turbana/cpu/doc/block_diagram.png

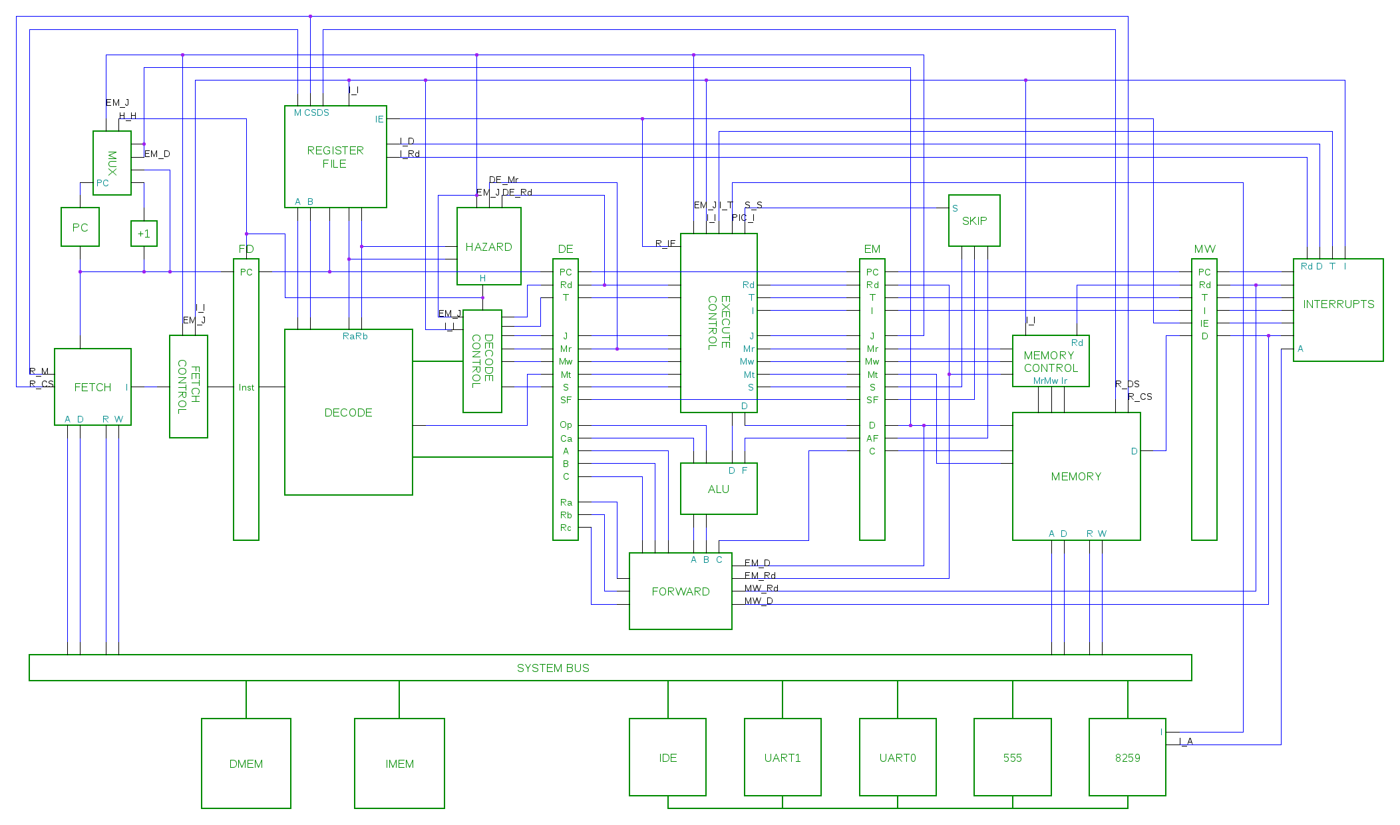
doc/block_diagram.png
