turbana/cpu/doc/schematics.pdf

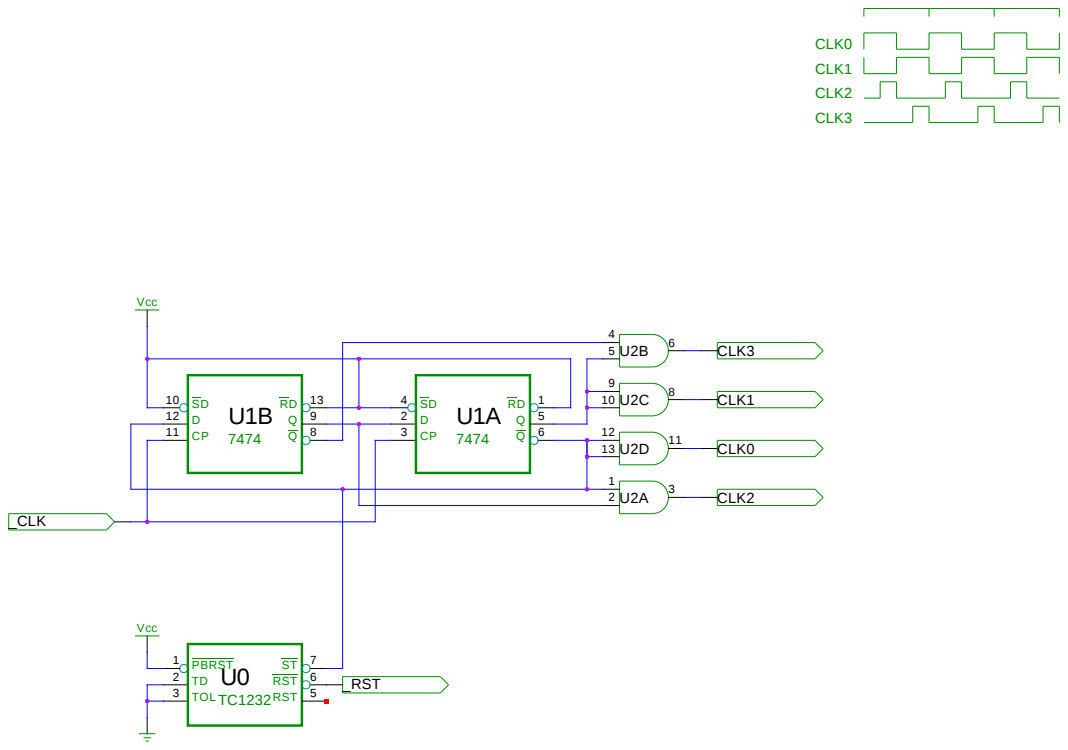
[picture p2: page 1]
FILE:; REVISION:; PAGE; DRAWN BY:; TITLE; Vcc; _CLK; CLK2; CLK0 CLK1 CLK2 CLK3; CLK3; CLK1; CLK0; _RST; 1 PBRST; 3 TOL; 7 ST RST 6 RST 5; CLOCK; 2016-08-04-103633 Ian Clark

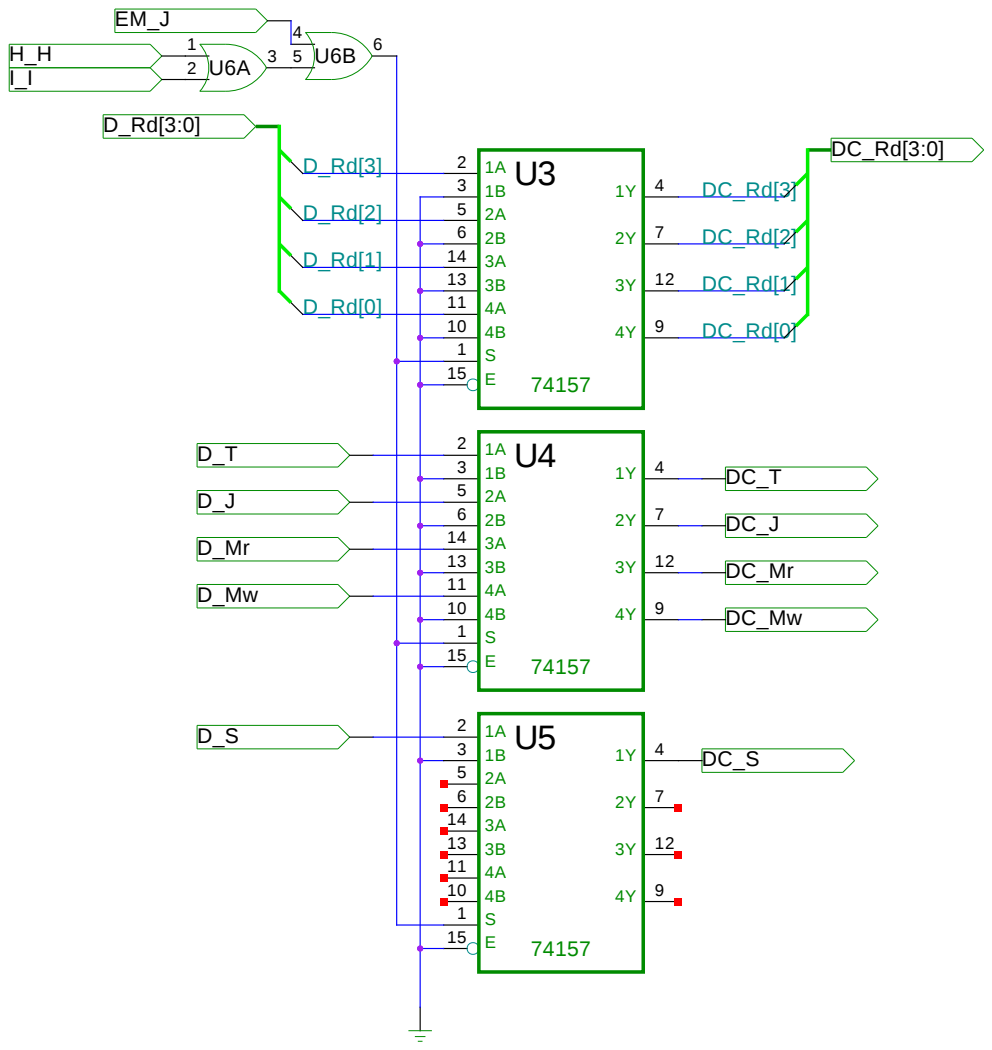
[picture p3: page 2]
FILE:; REVISION:; PAGE; DRAWN BY:; TITLE; DECODE CONTROL; 2016-07-01-140532 Ian Clark

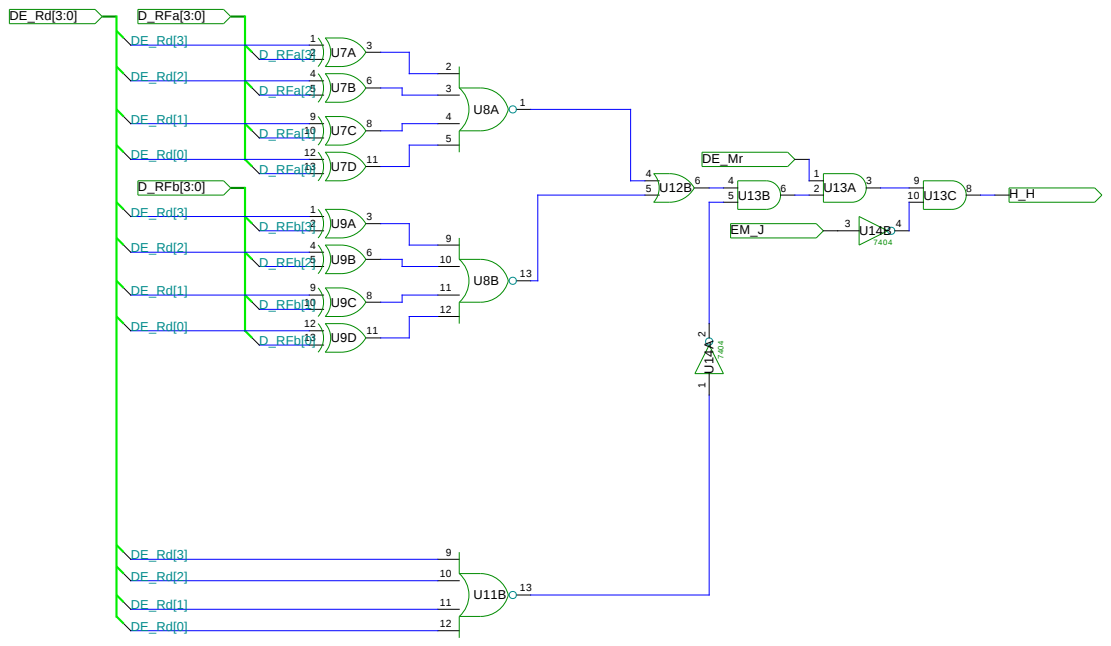
[picture p4: page 3]

# 7 EN 4 I0

# 10 S1 9 S2 3 I1 2 I2 1 I3

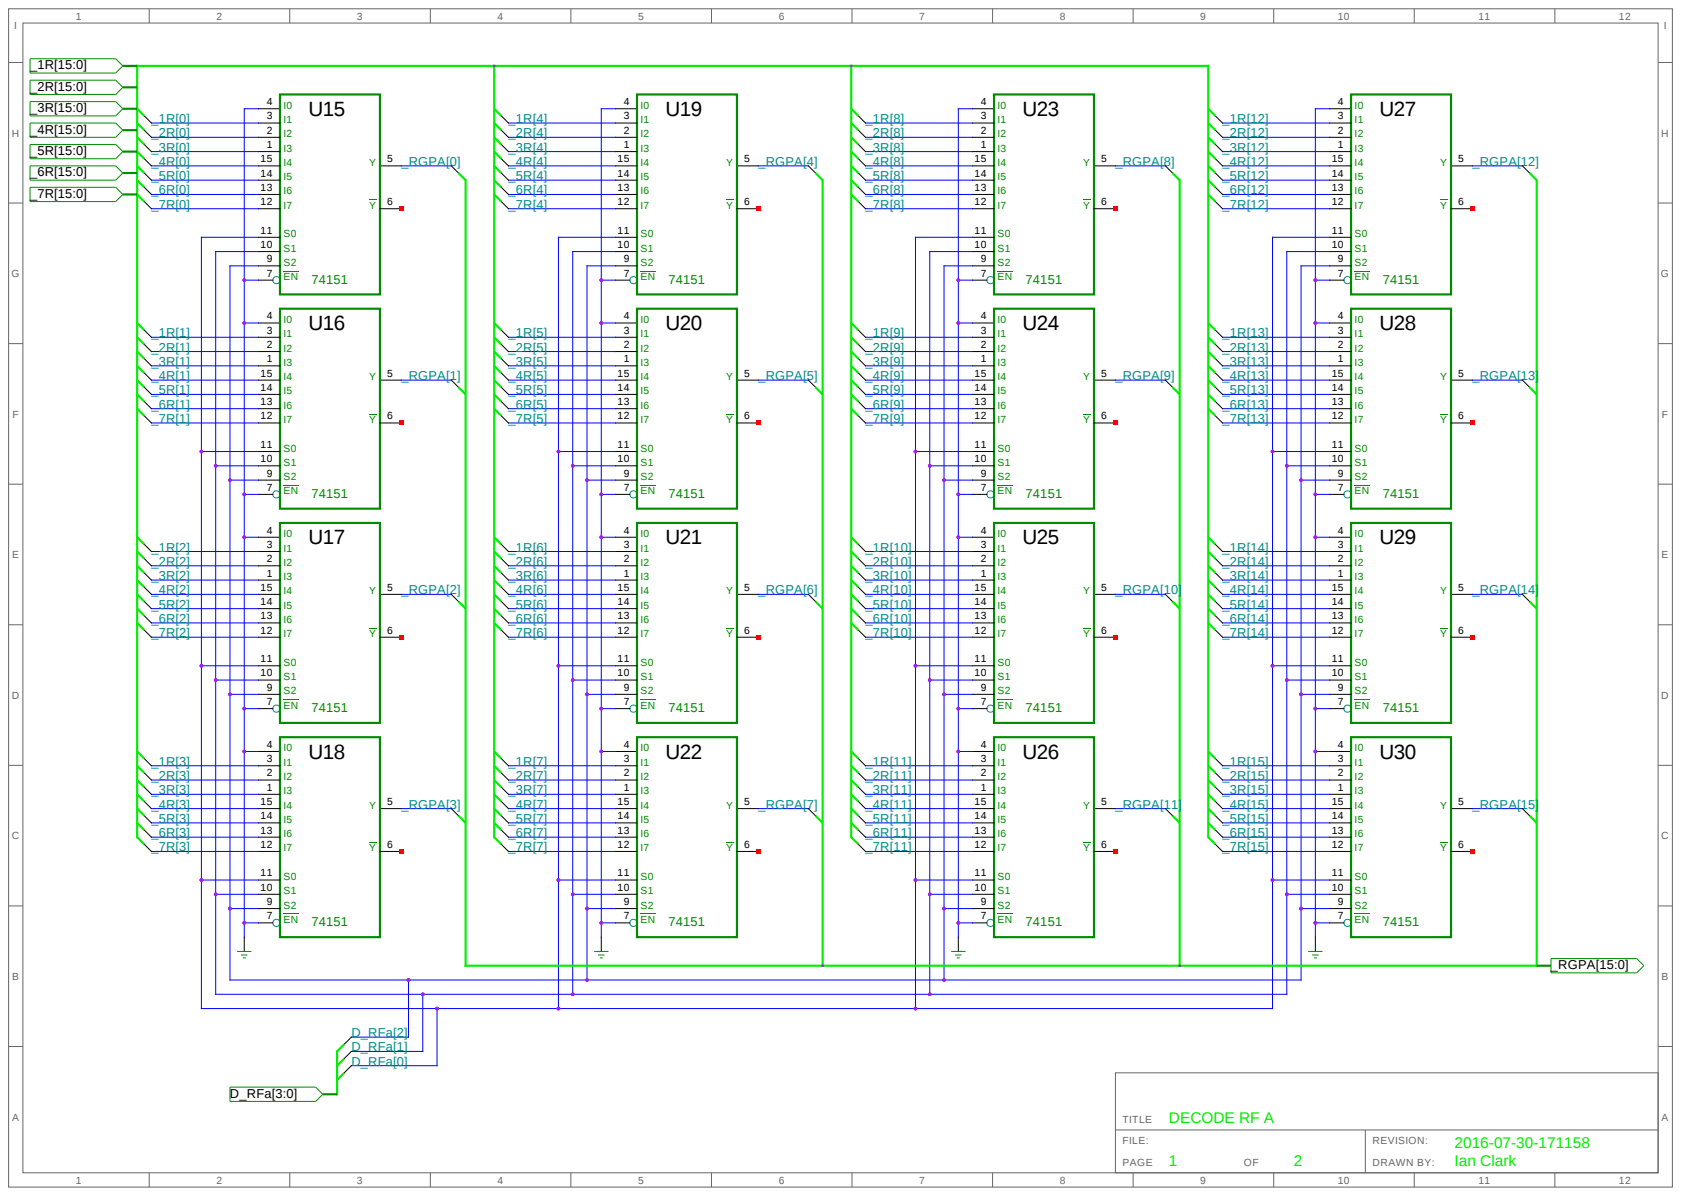
[picture p5: page 4]

# 1 EN1 2 B 3 1C3 4 1C2 5 1C1 6 1C0

U31

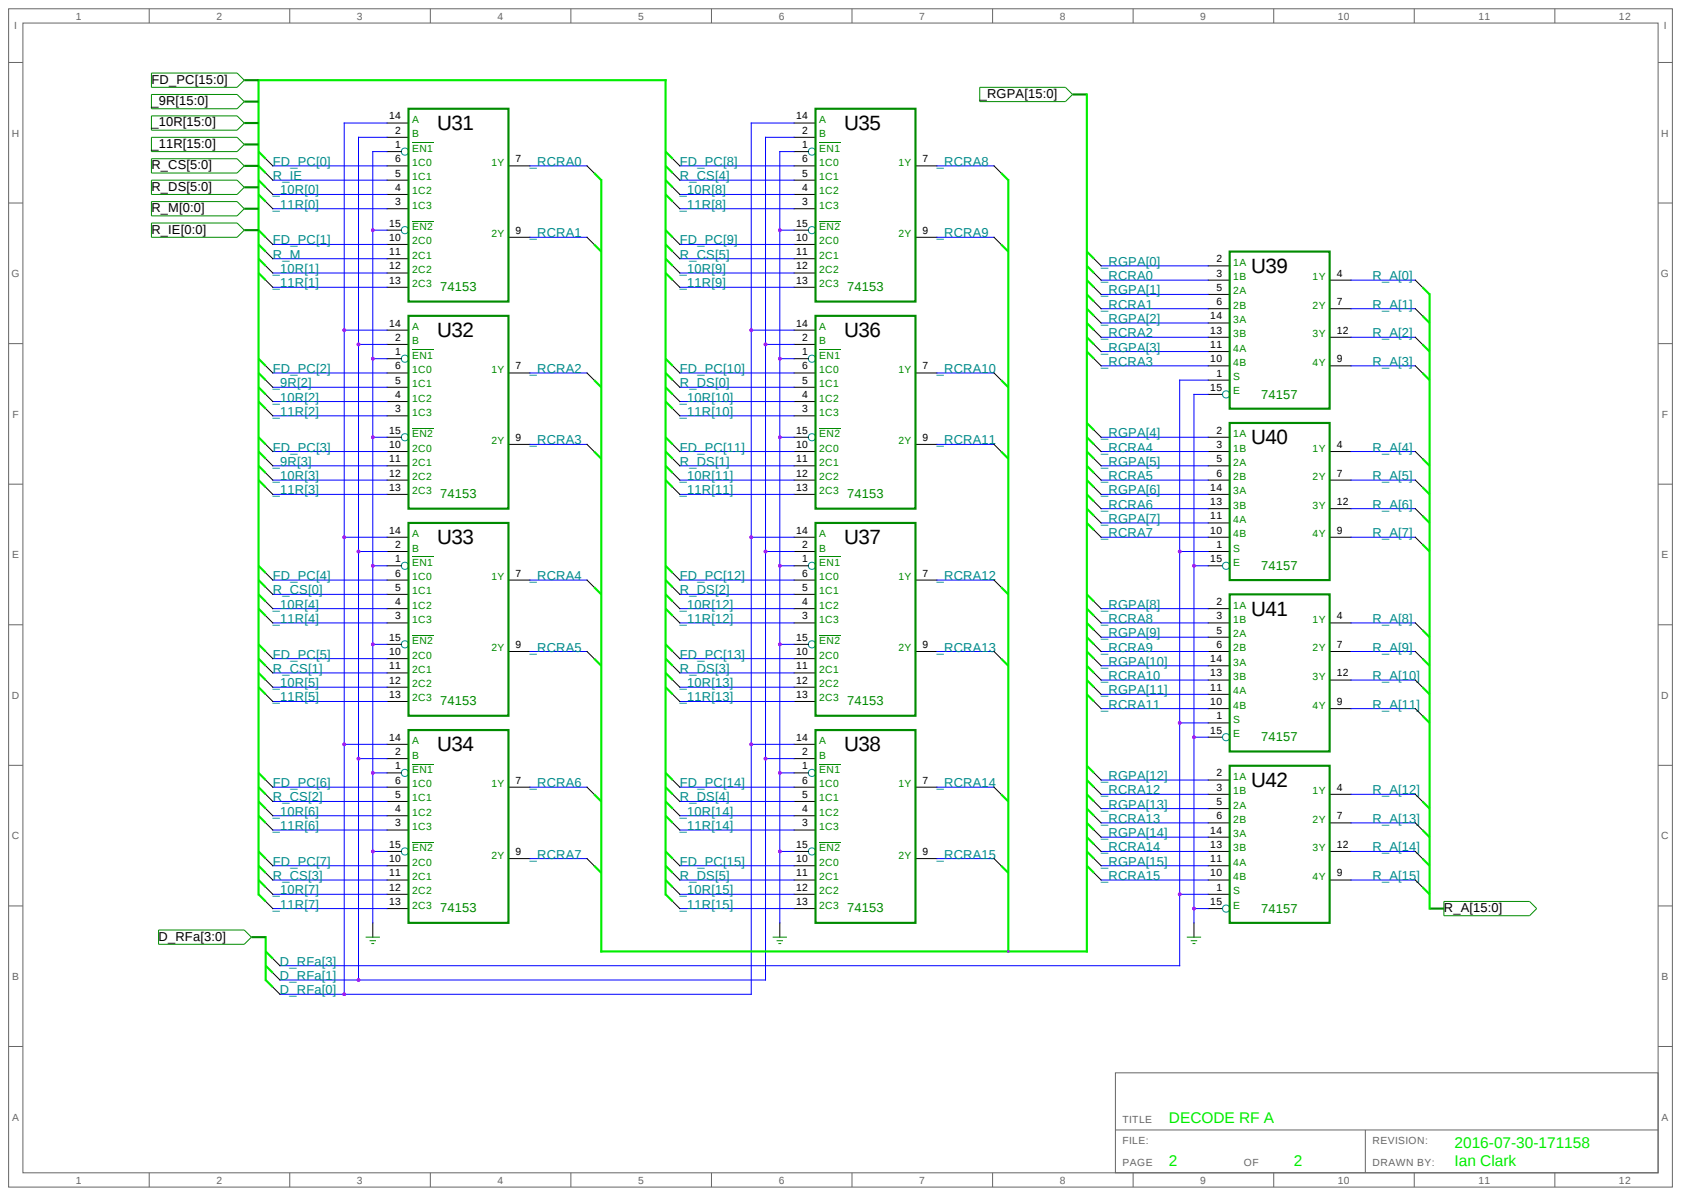
[picture p6: page 5]

# 7 EN 4 I0

# 10 S1 9 S2 3 I1 2 I2 1 I3

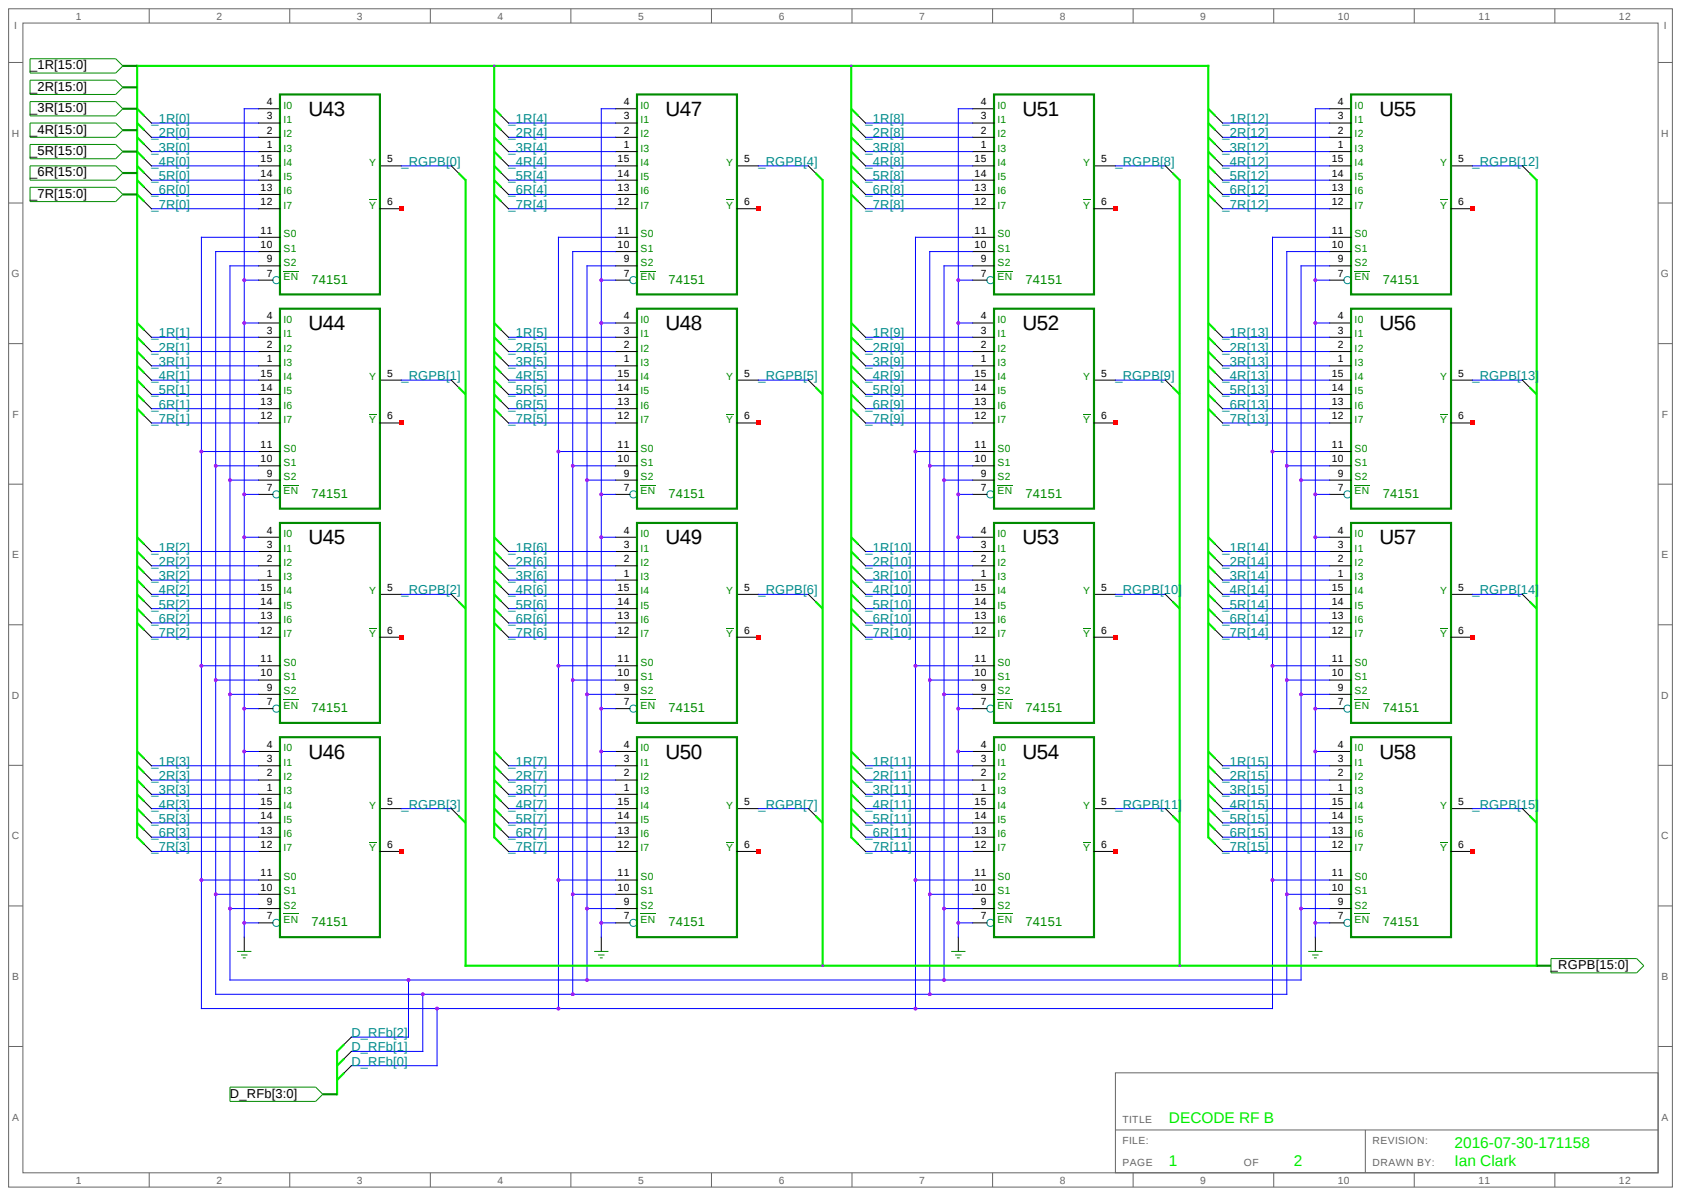
[picture p7: page 6]

# 1 EN1 2 B 3 1C3 4 1C2 5 1C1 6 1C0

U59

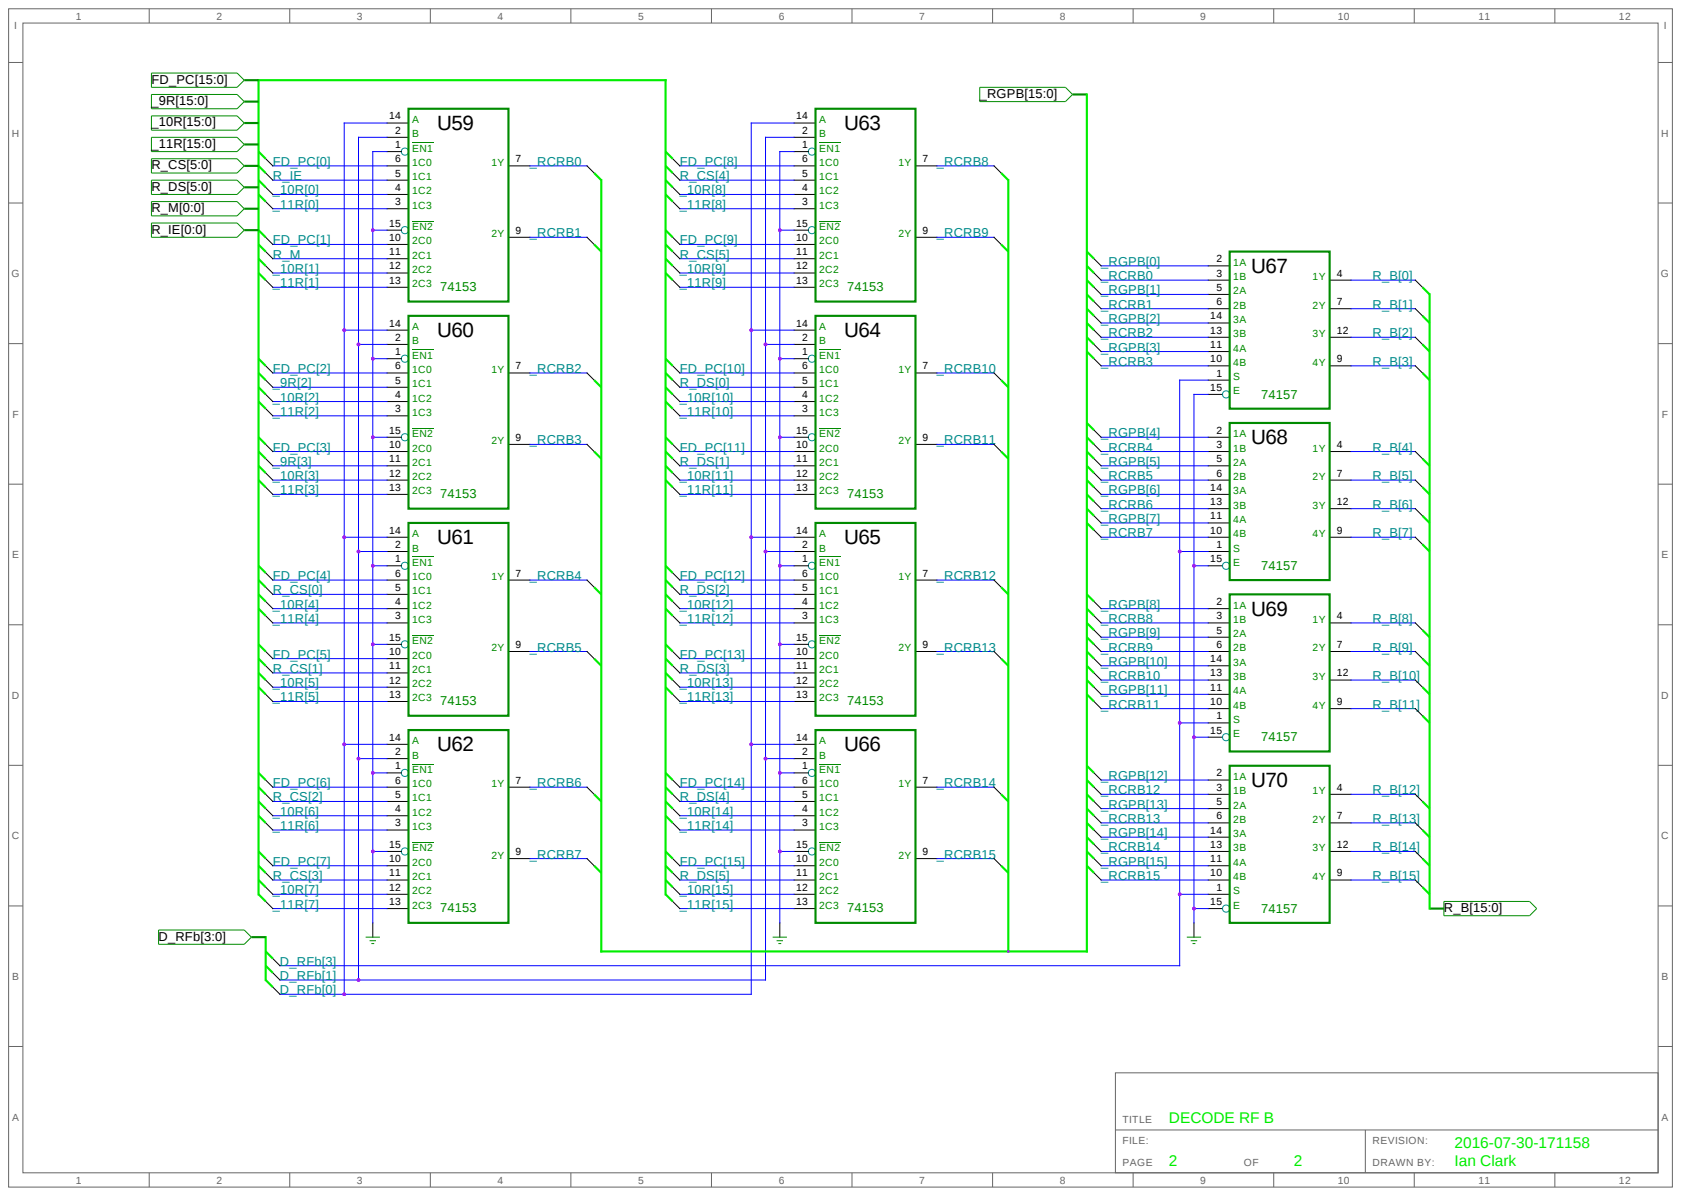
[picture p8: page 7]

U99

U367

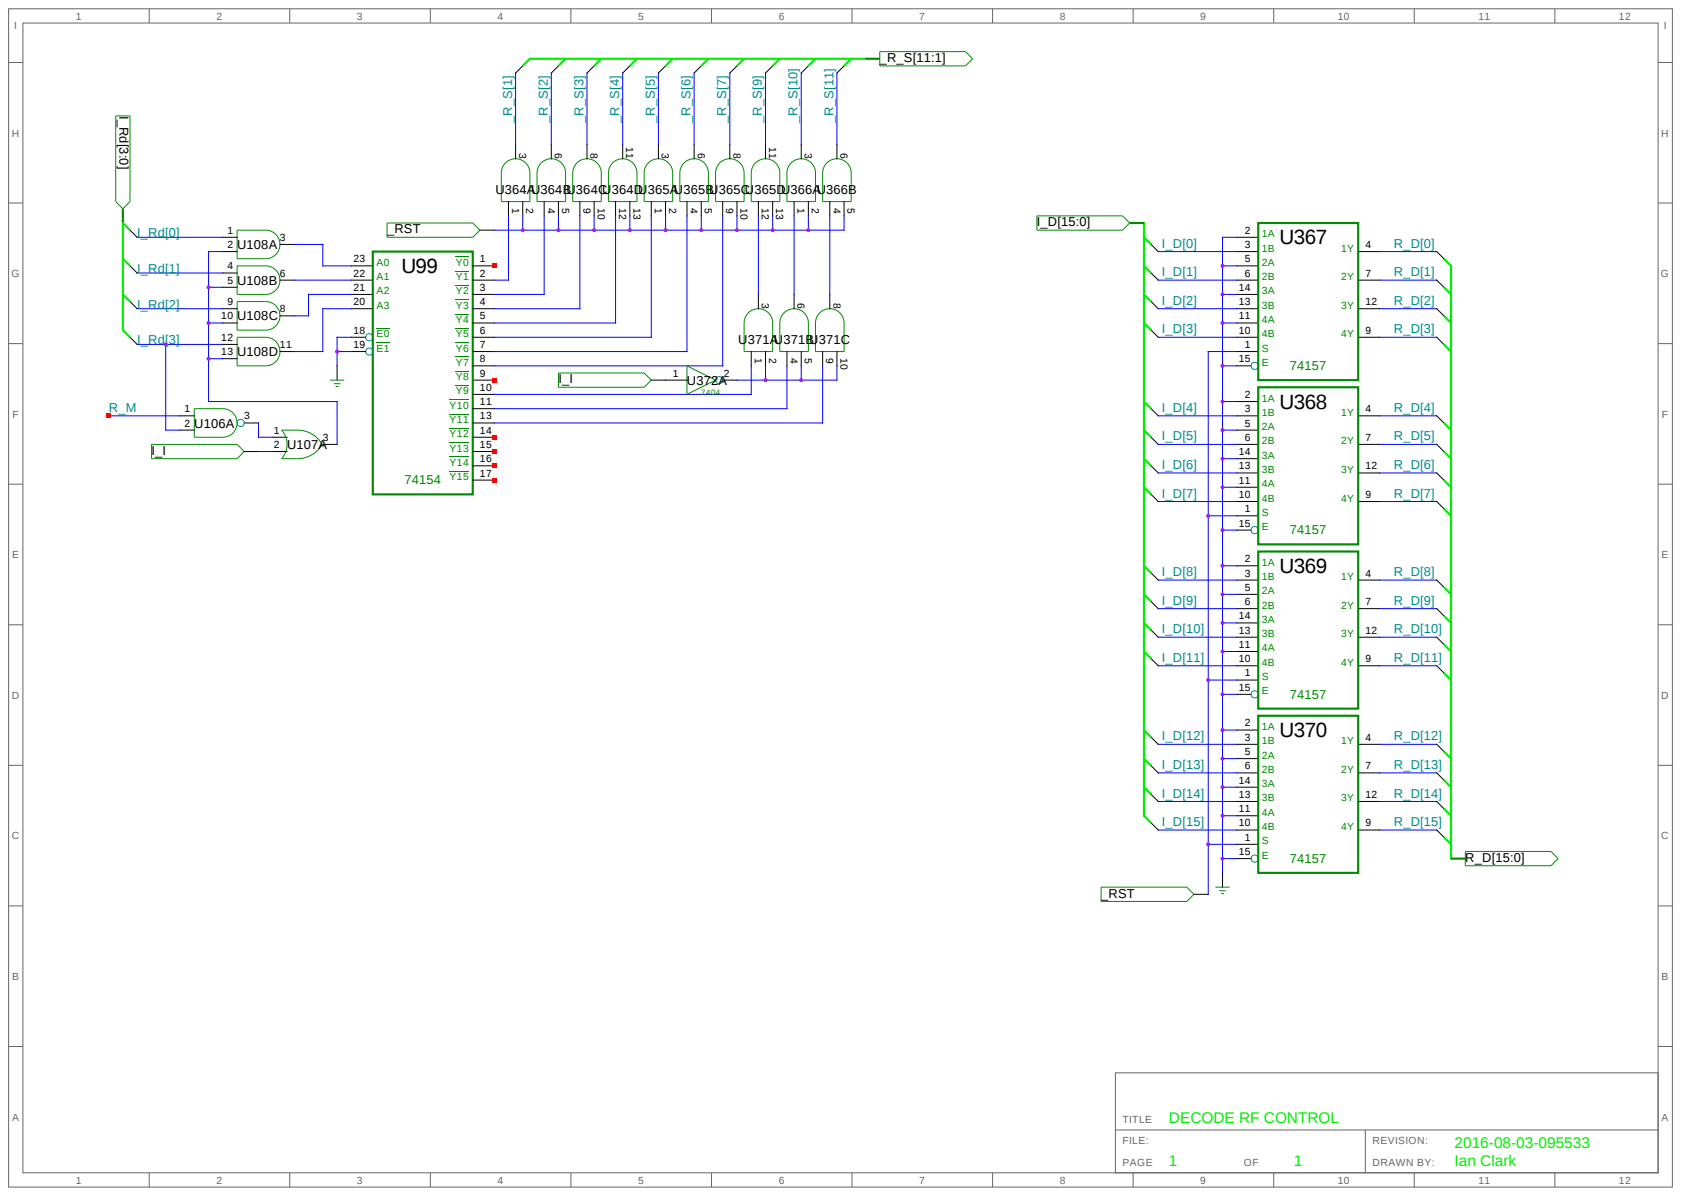
[picture p9: page 8]

U101

U105

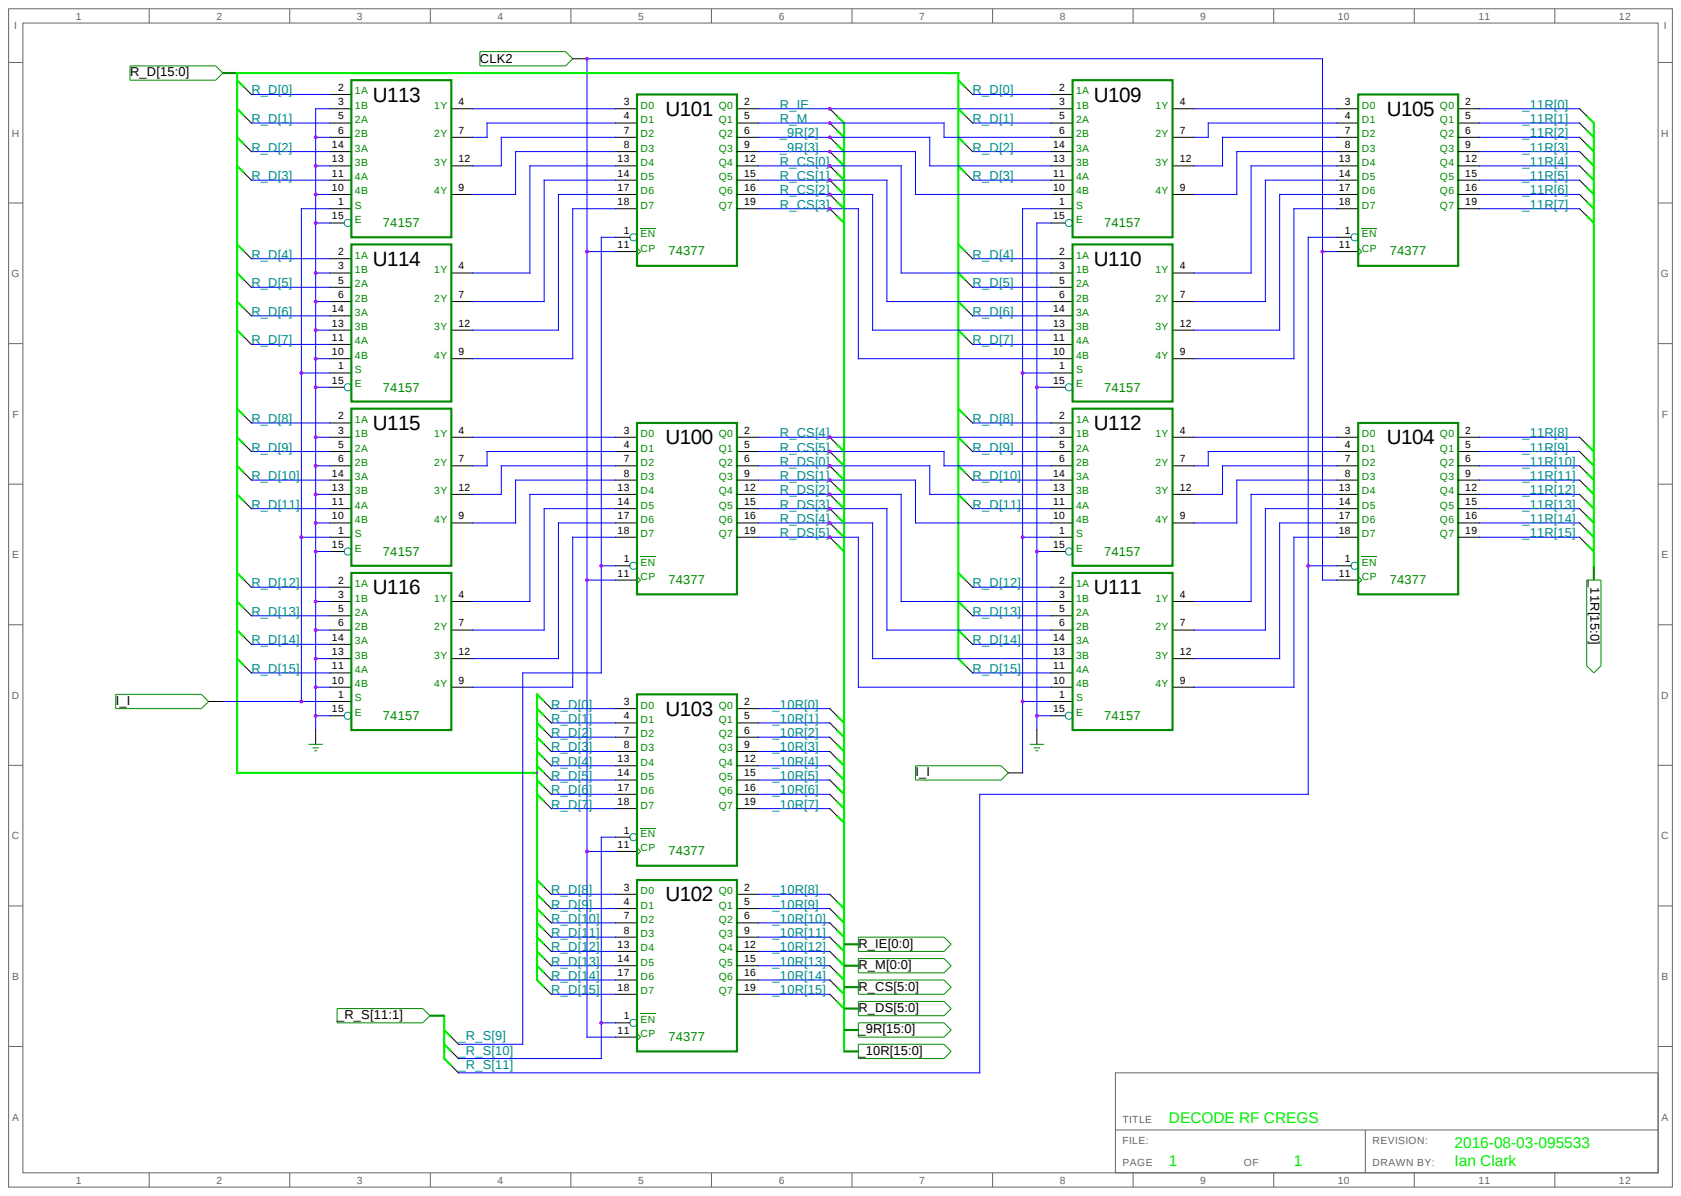
[picture p10: page 9]

14 D5
17 D6
18 D7

U118

U122

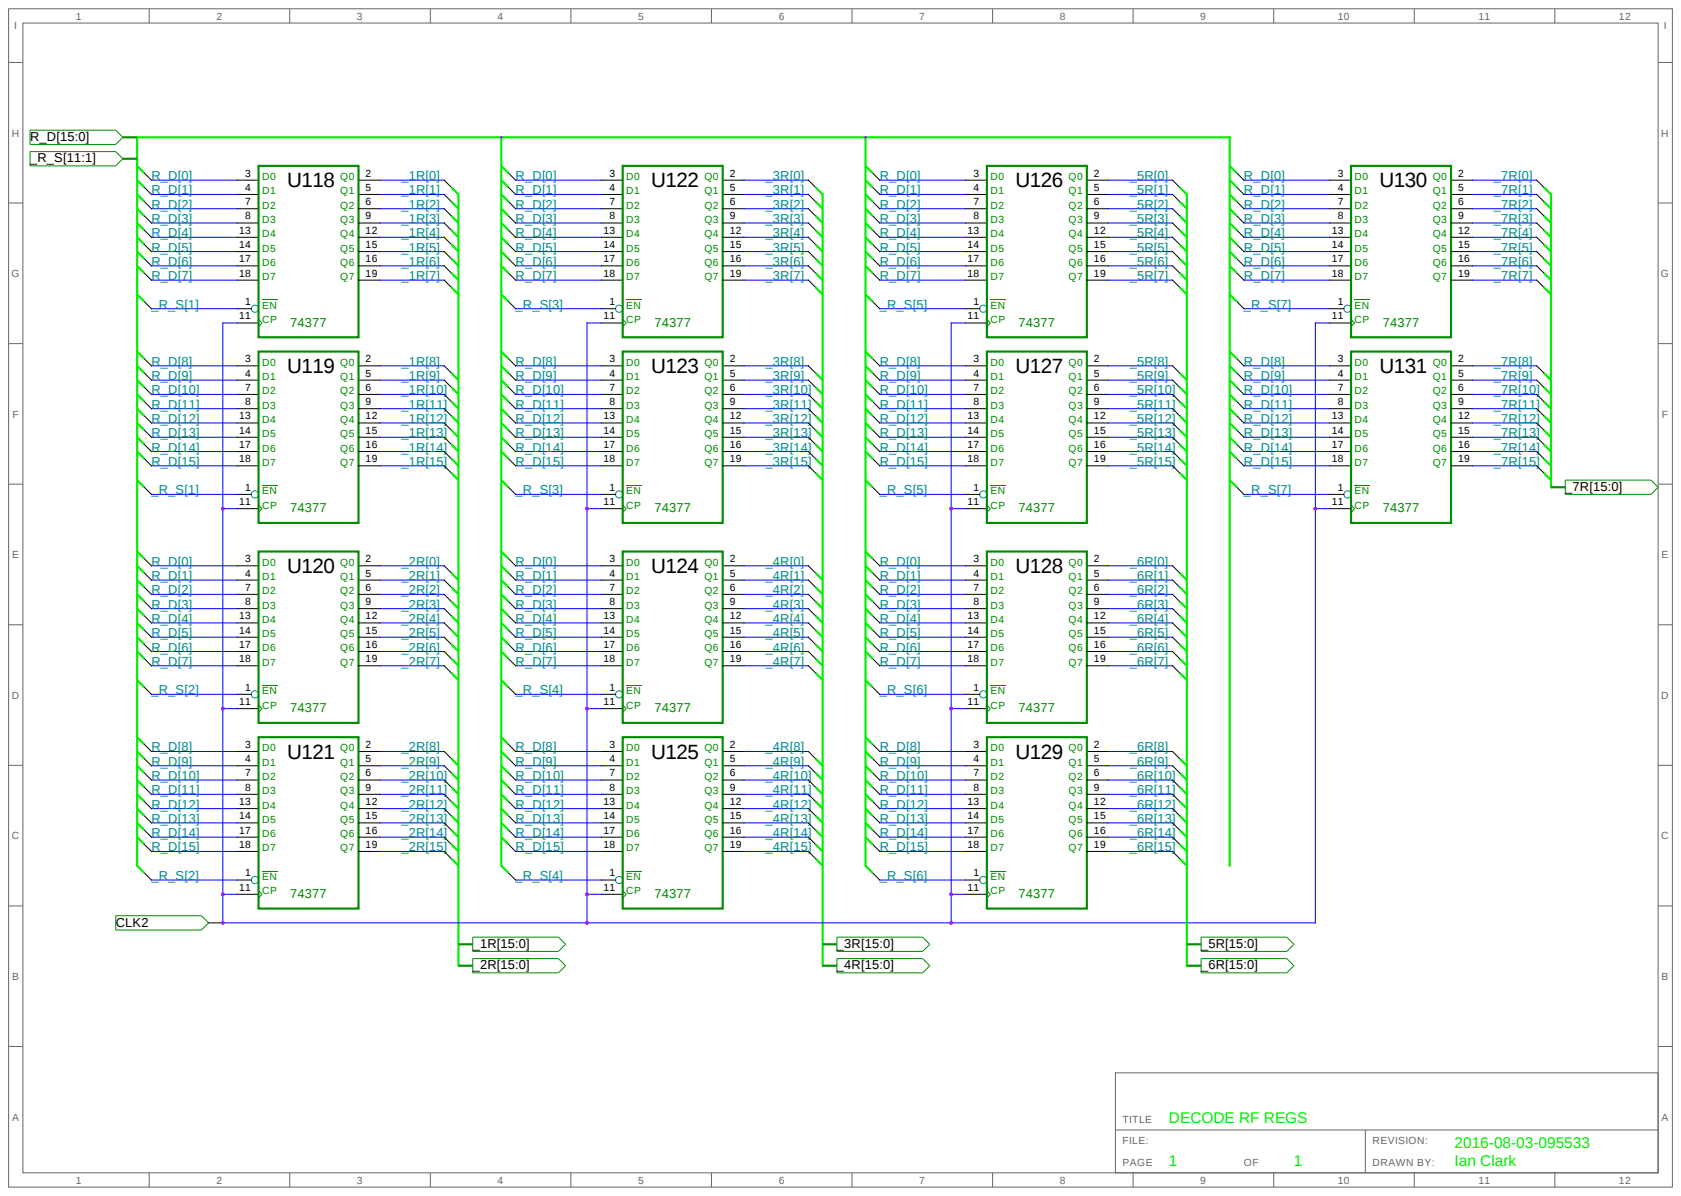
[picture p11: page 10]

U132
U136

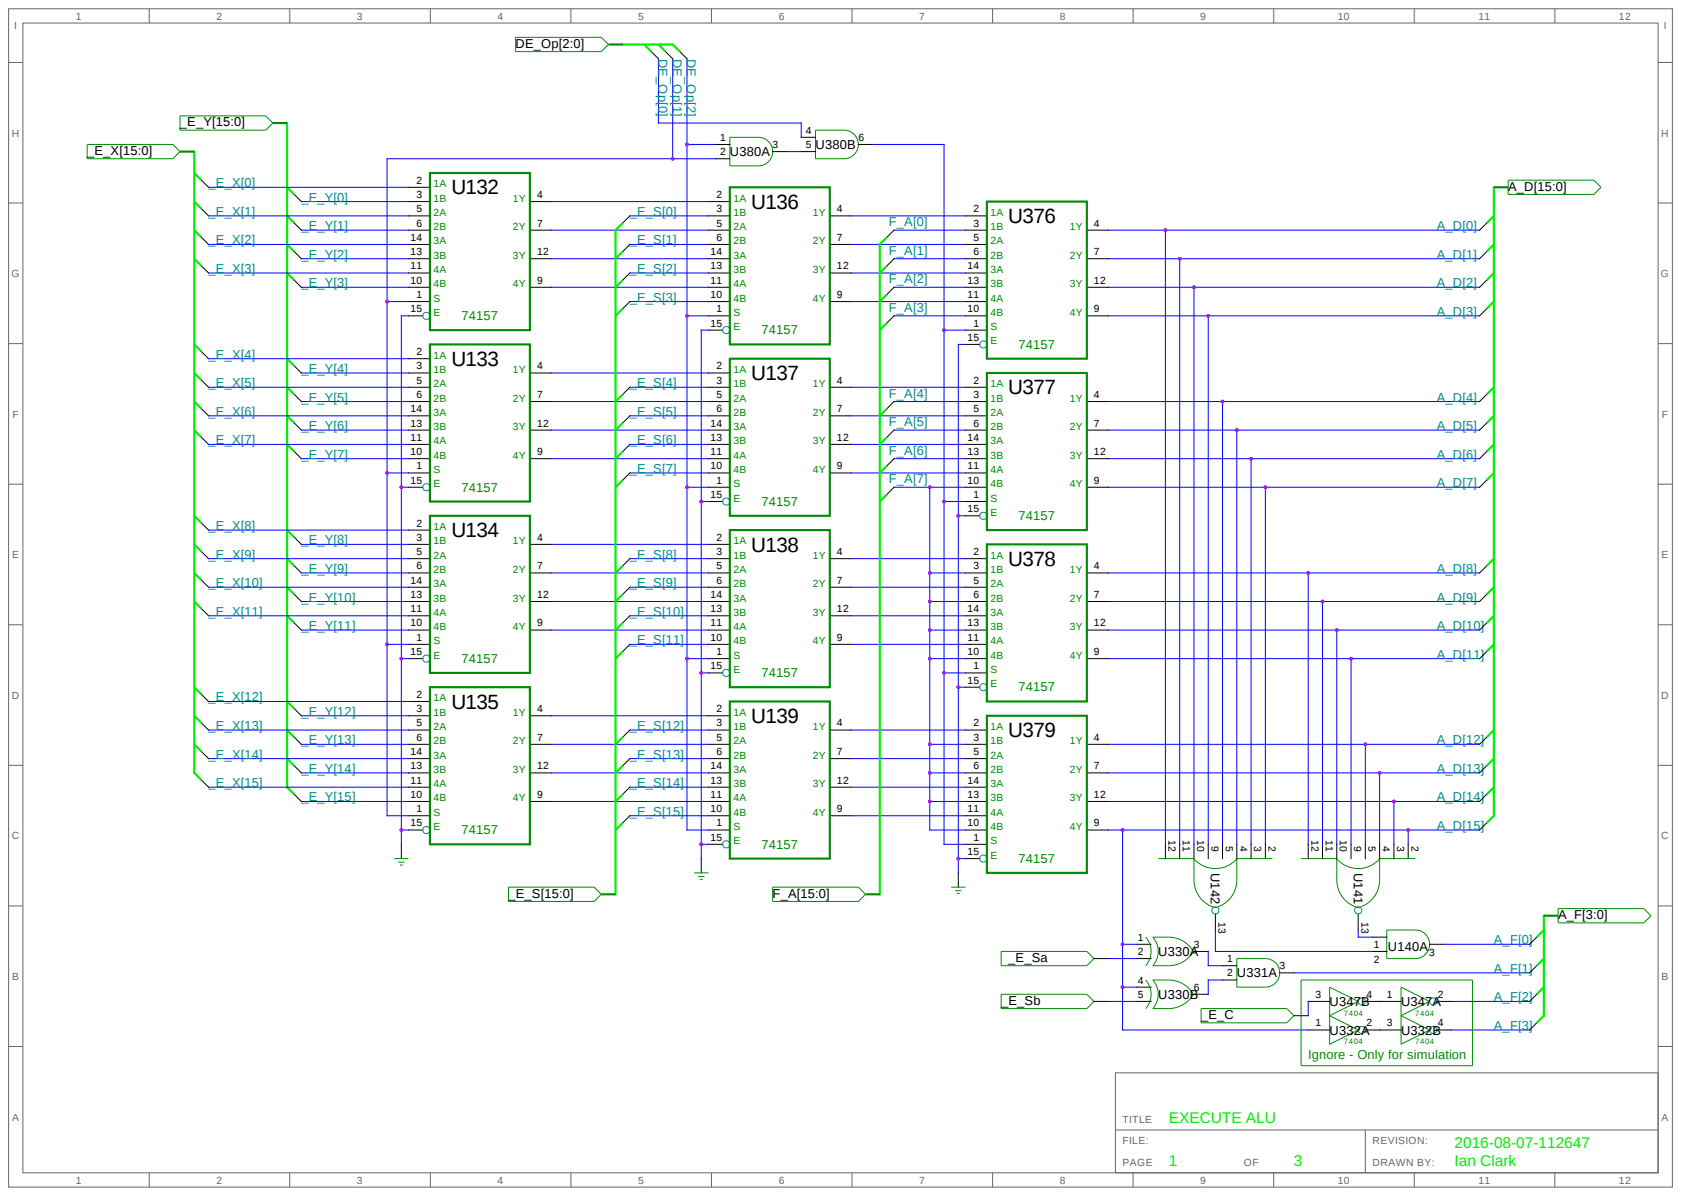
[picture p12: page 11]

6 2B
14 3A

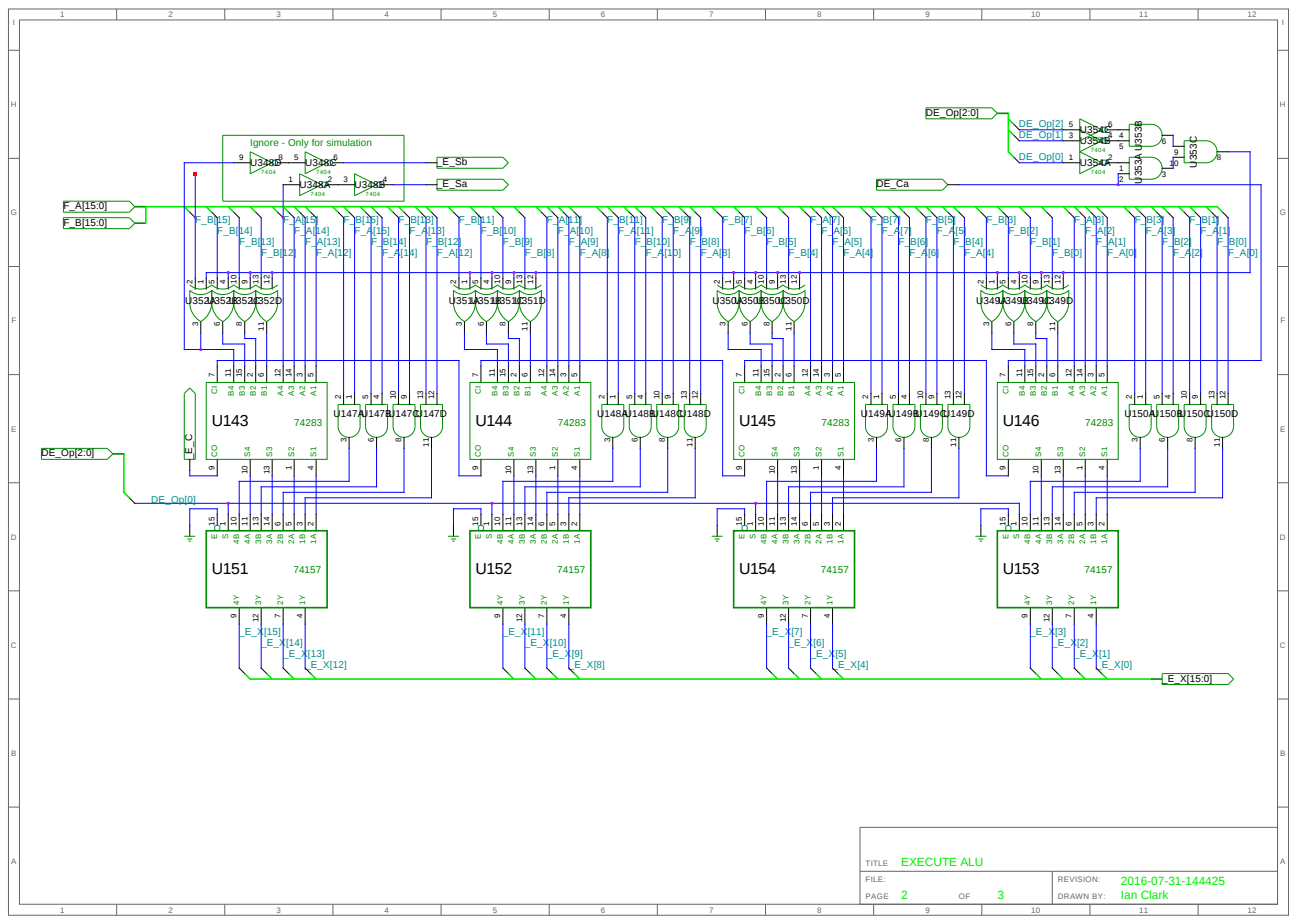
[picture p13: page 12]

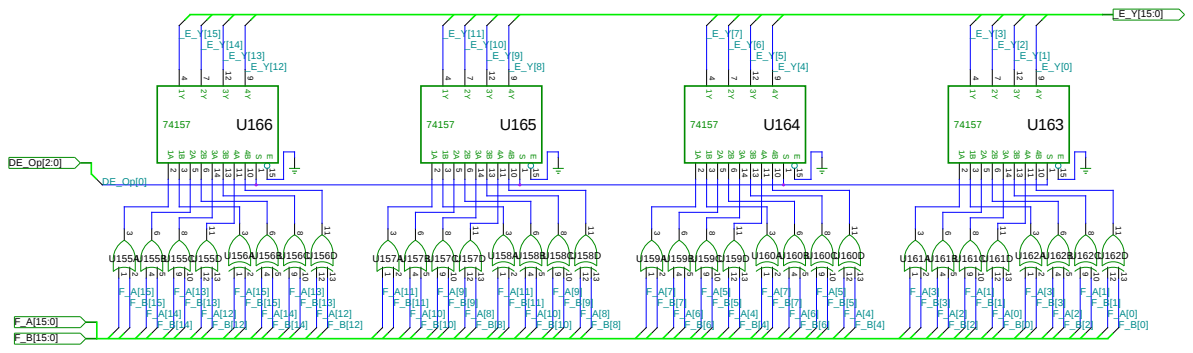
[picture p14: page 13]

U167
U171

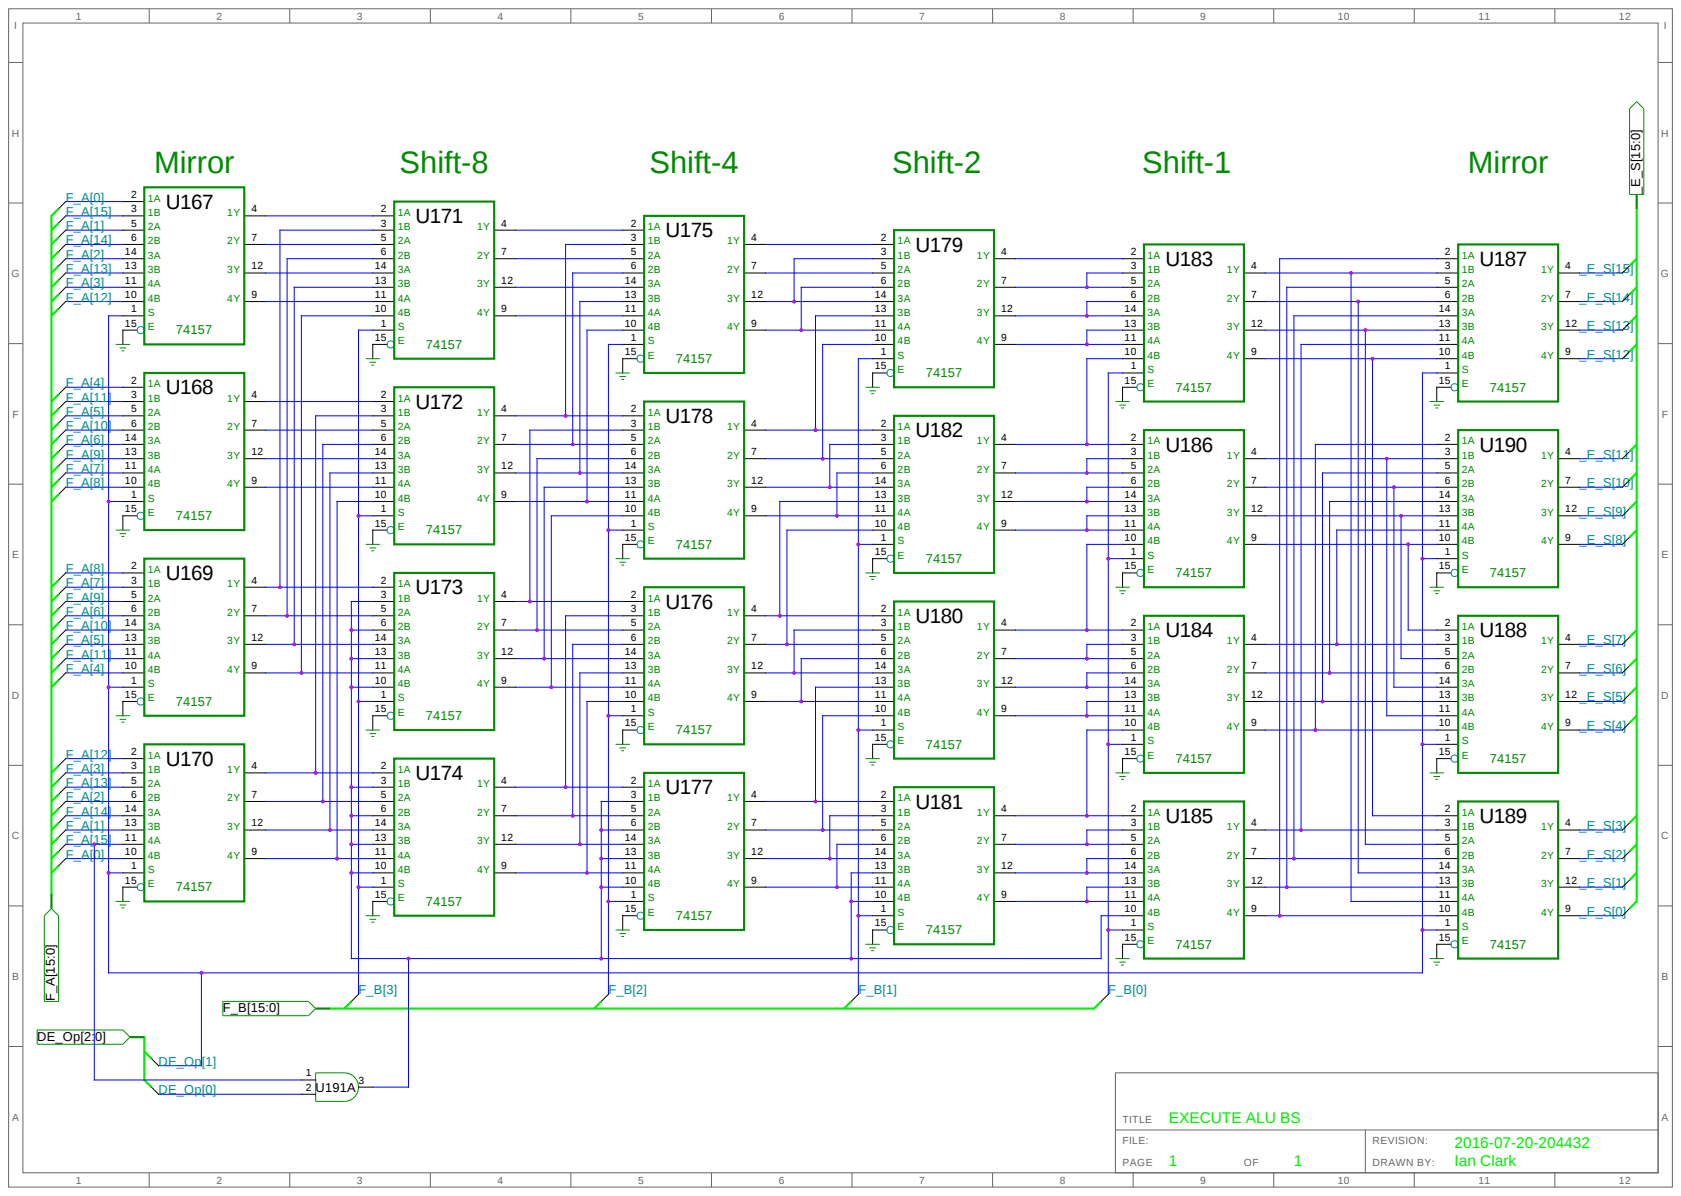
[picture p15: page 14]

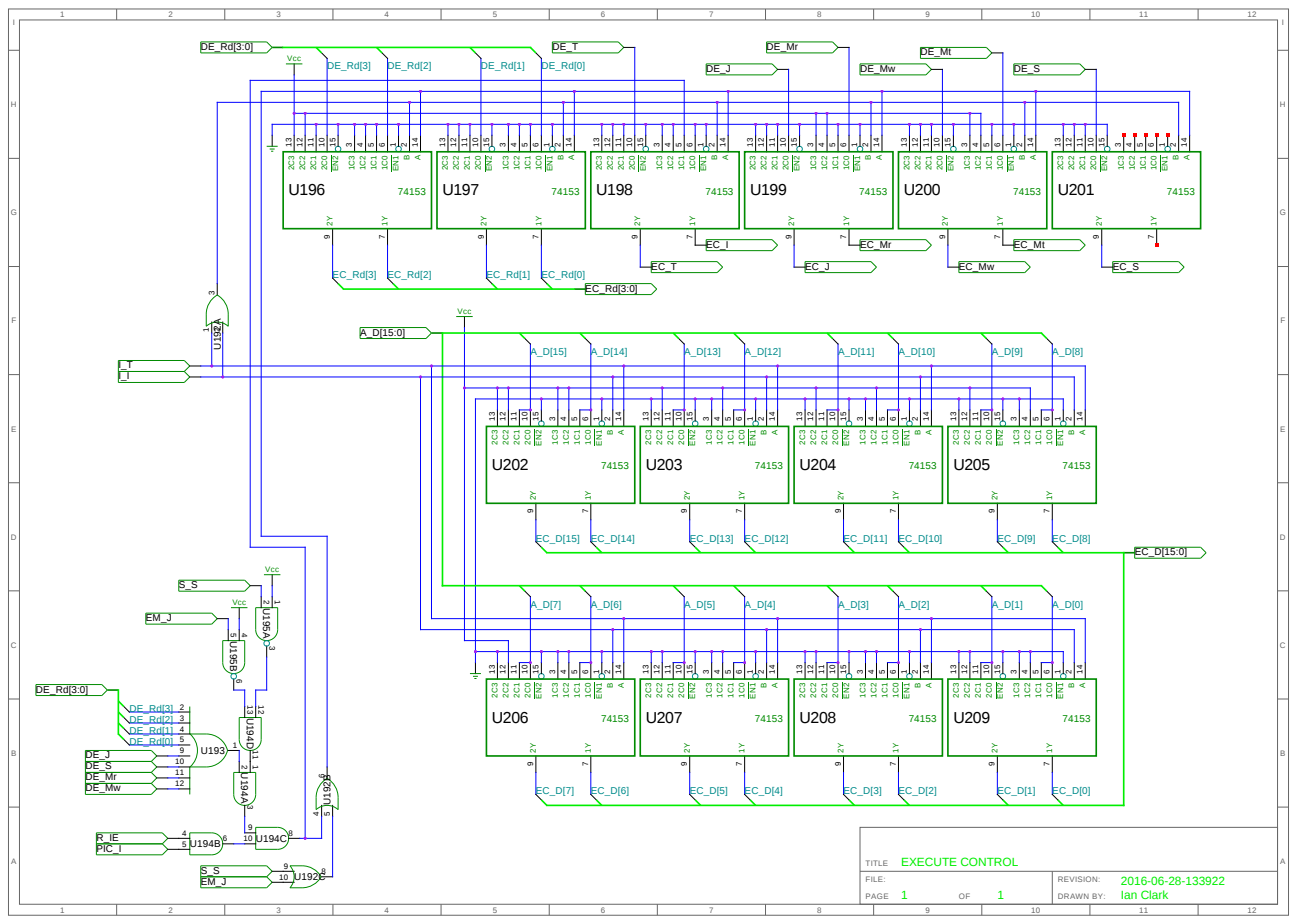
[picture p16: page 15]

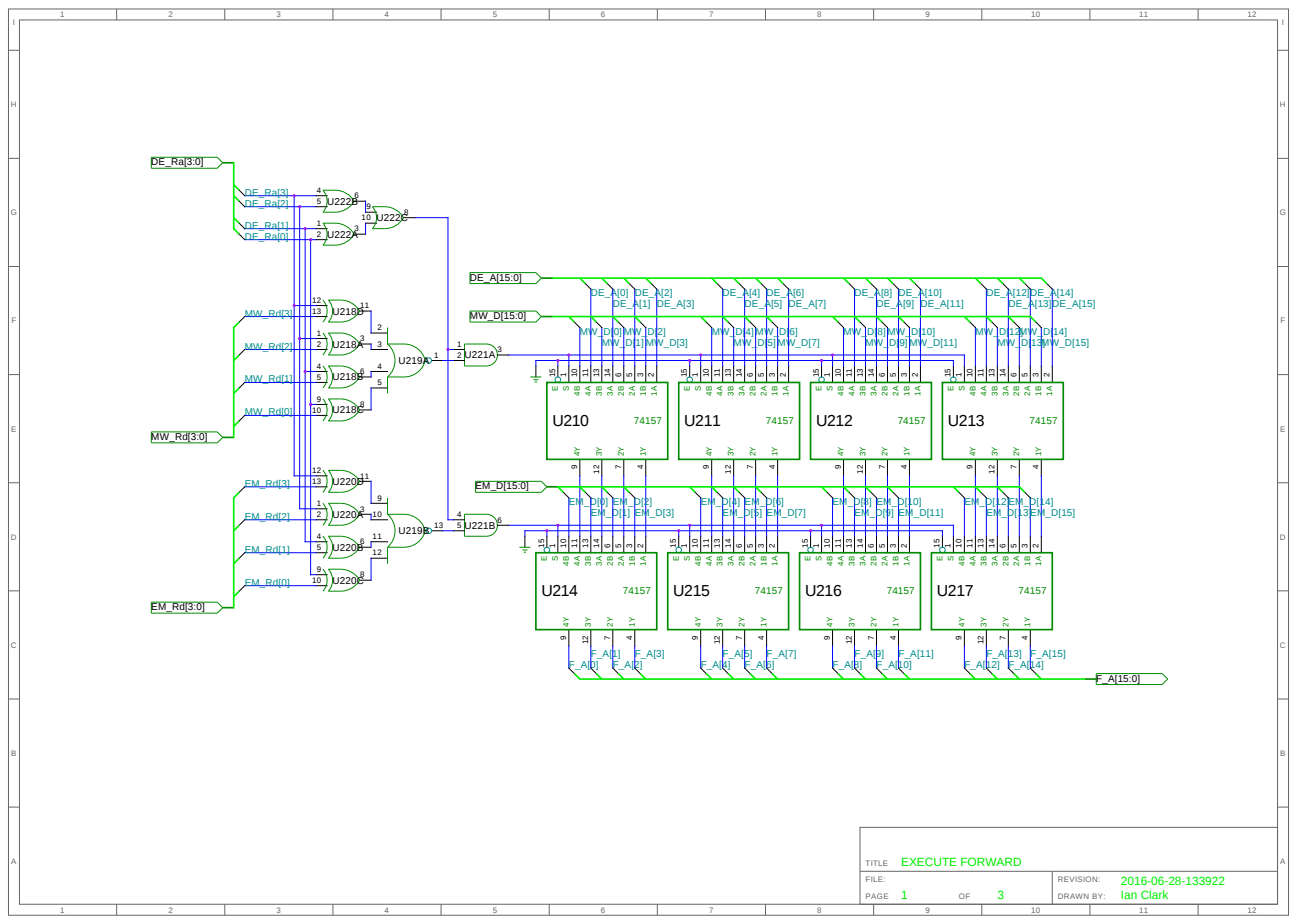
[picture p17: page 16]

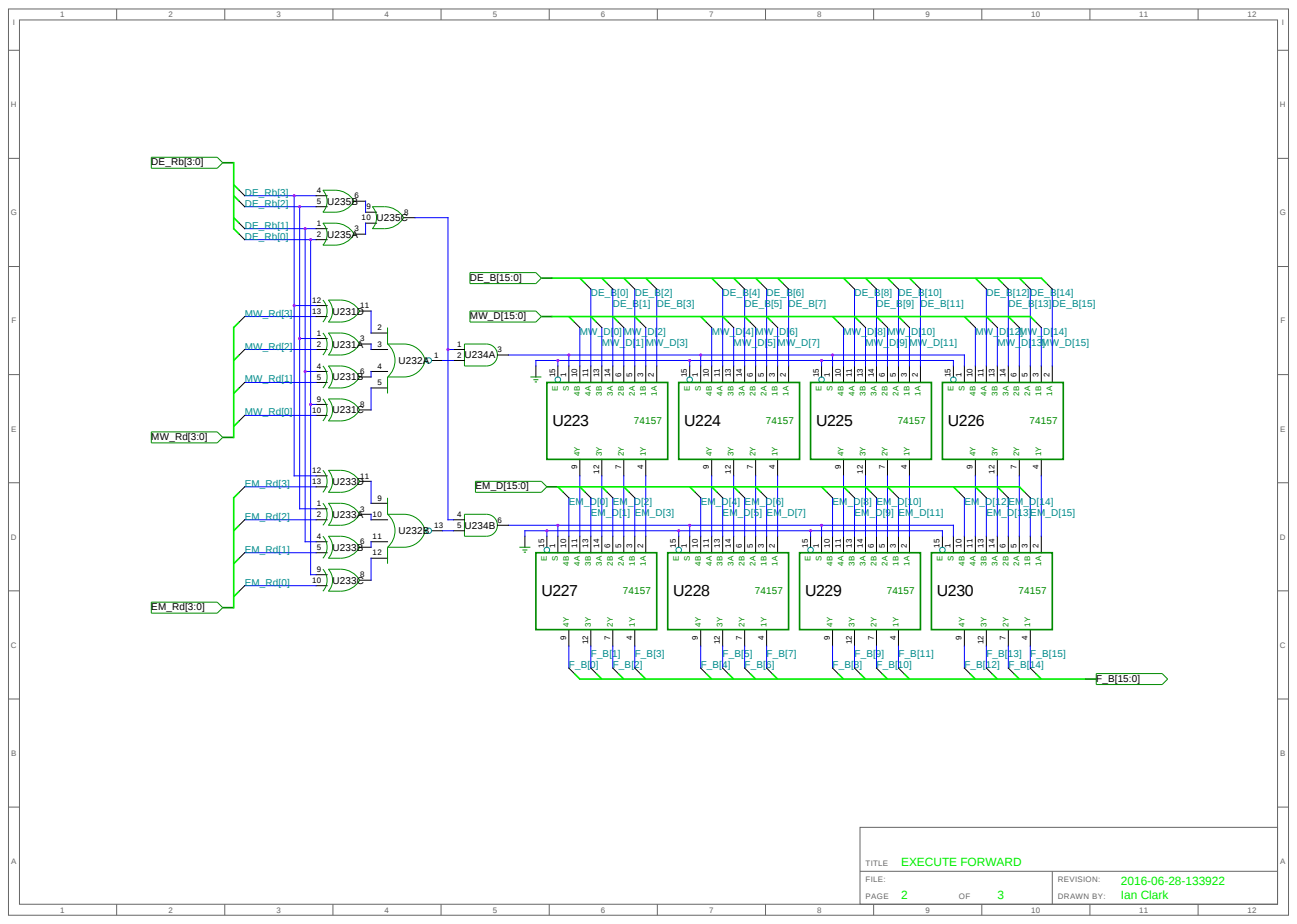
[picture p18: page 17]

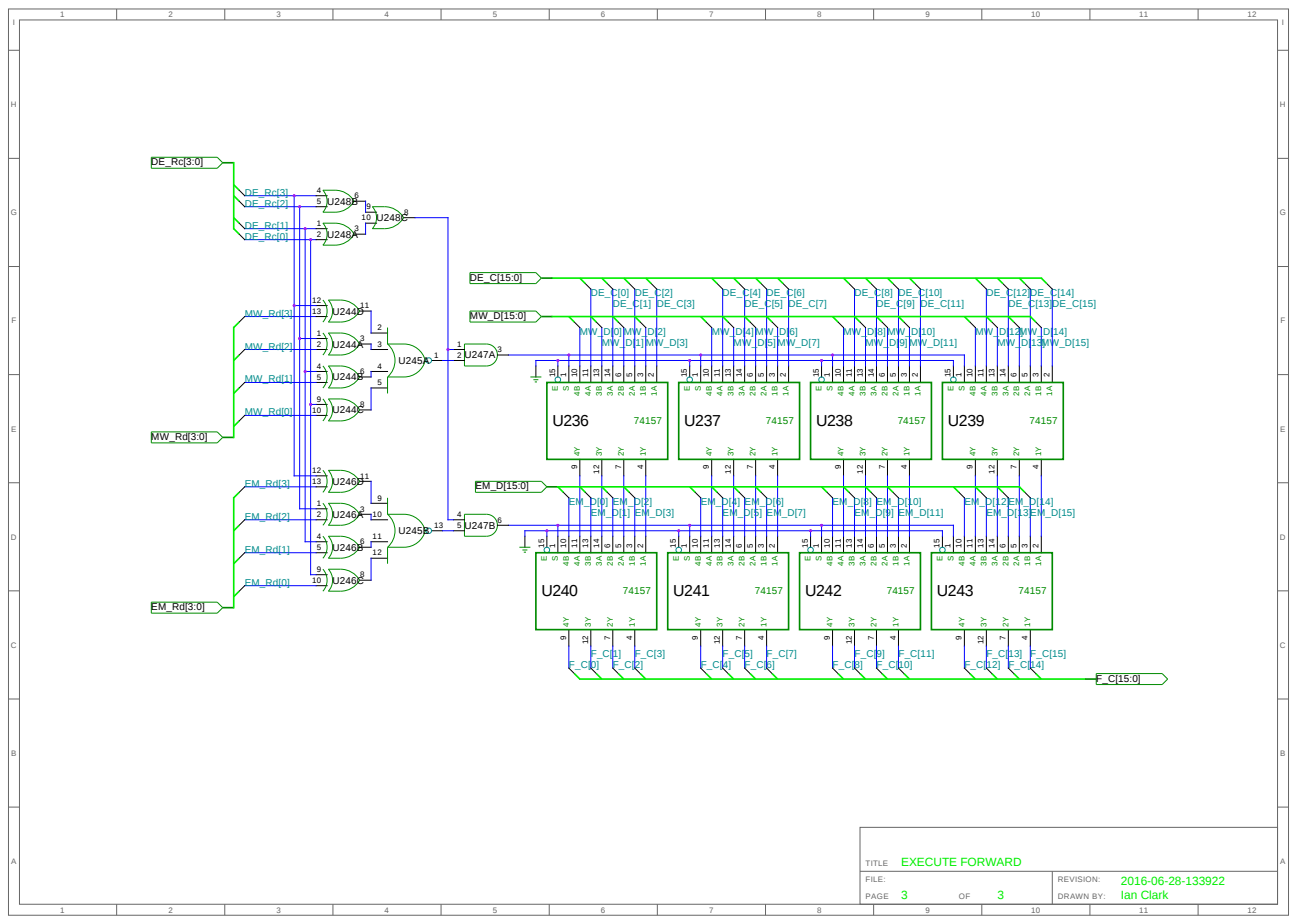
[picture p19: page 18]

U341

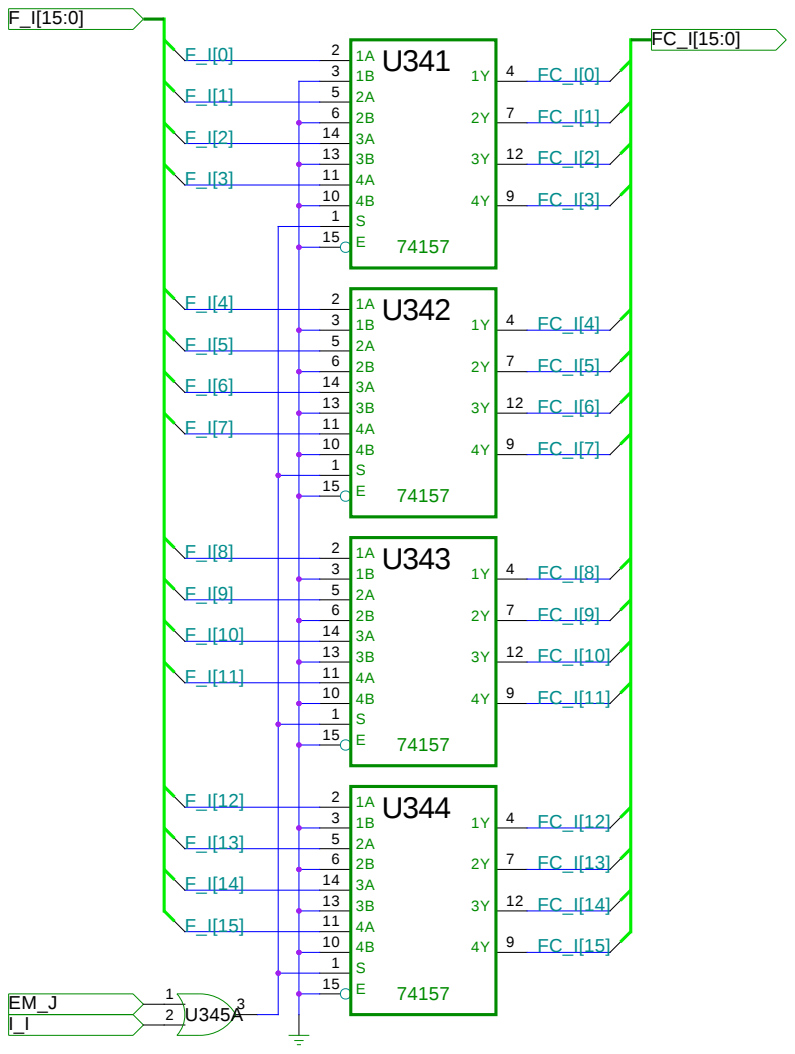
[picture p20: page 19]
FILE:; REVISION:; PAGE; DRAWN BY:; TITLE BCDEFGH; ABCDEFGH; FETCH CONTROL; 2016-07-01-142341 Ian Clark

U249

U251

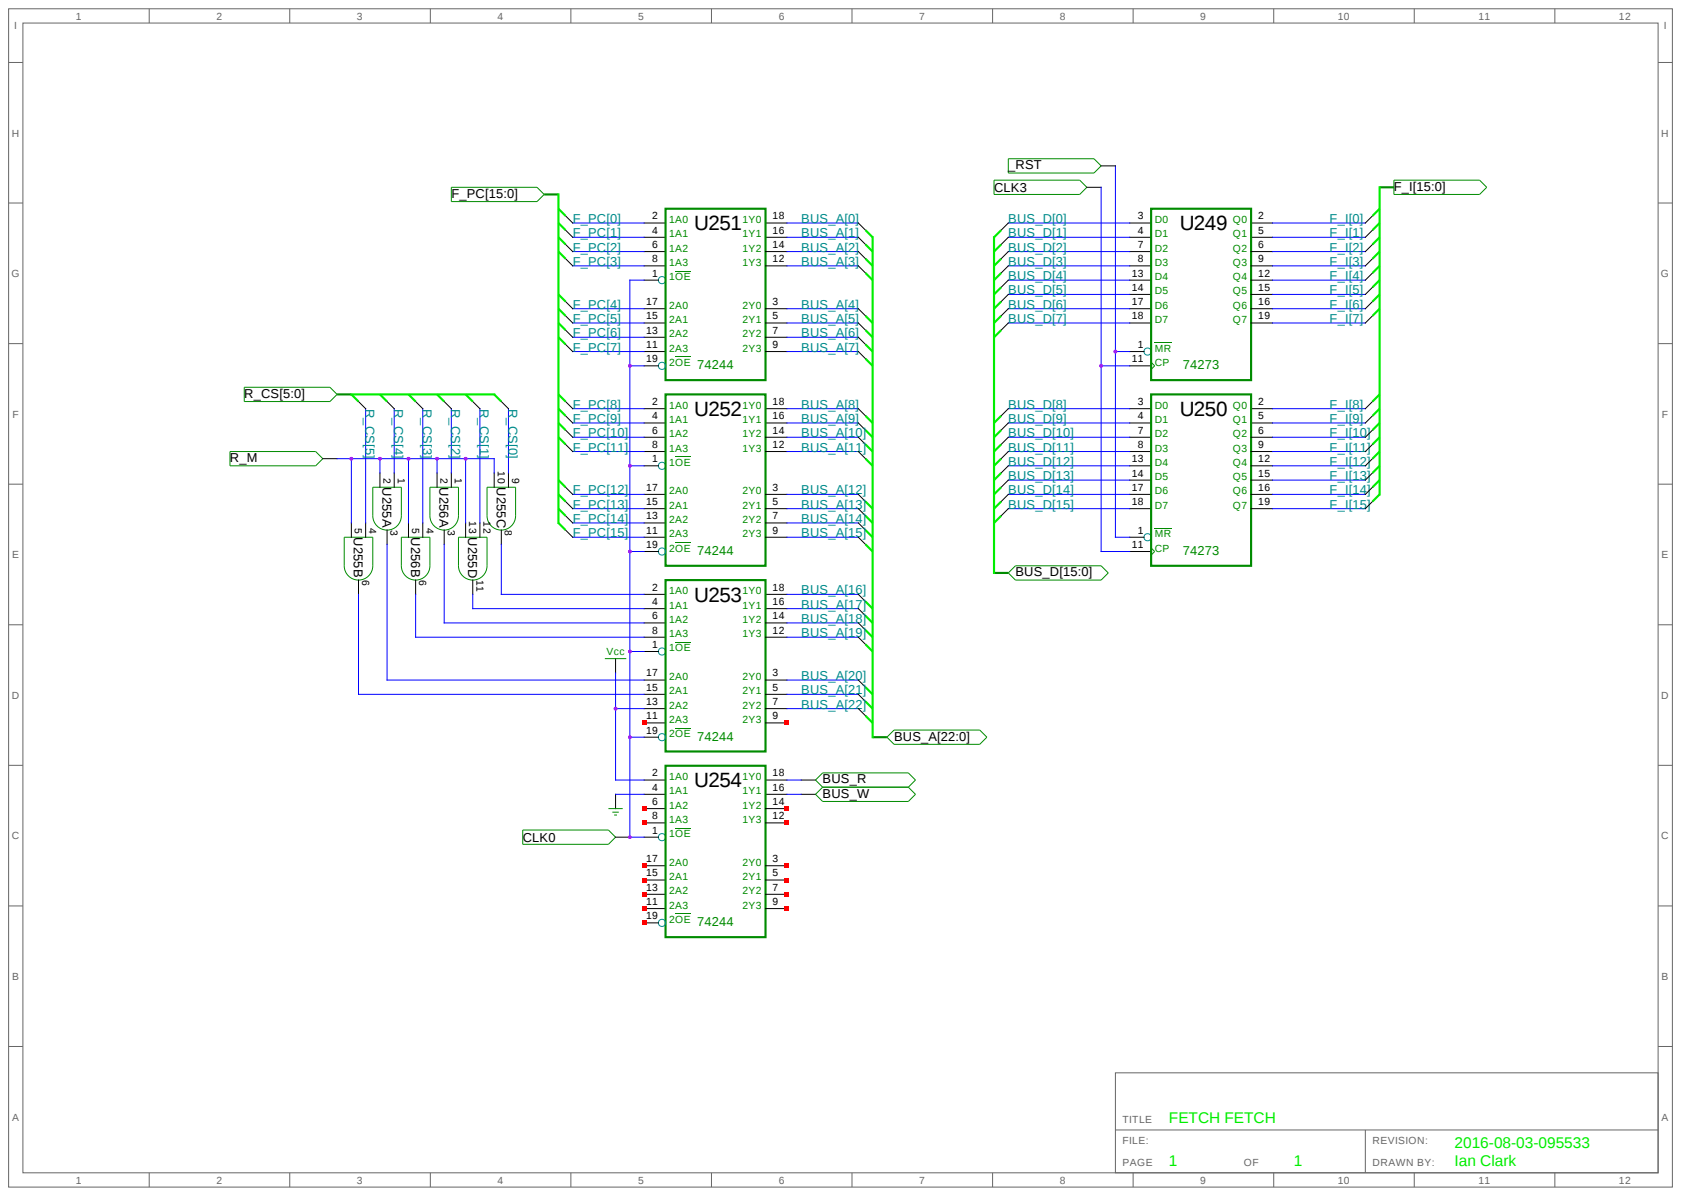
[picture p21: page 20]

U257

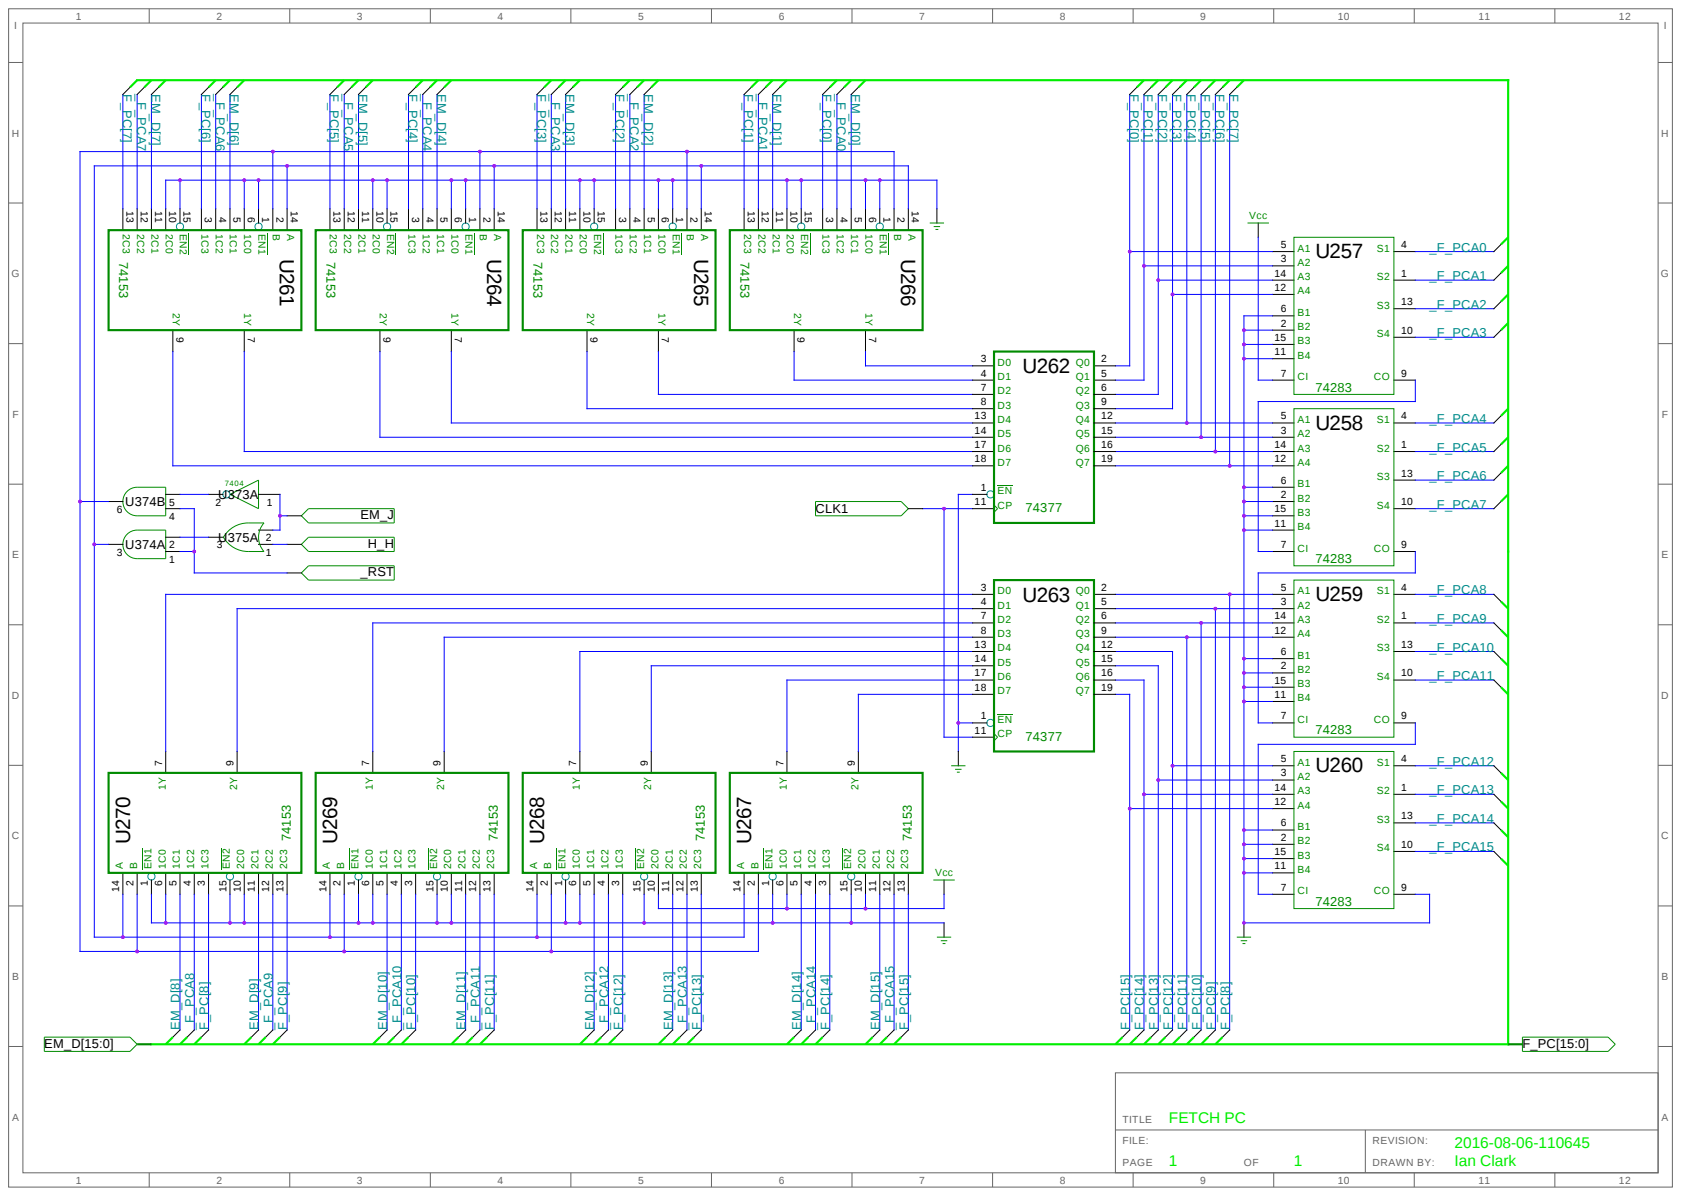
[picture p22: page 21]

4 D1
7 D2
8 D3
13 D4
14 D5
17 D6
18 D7

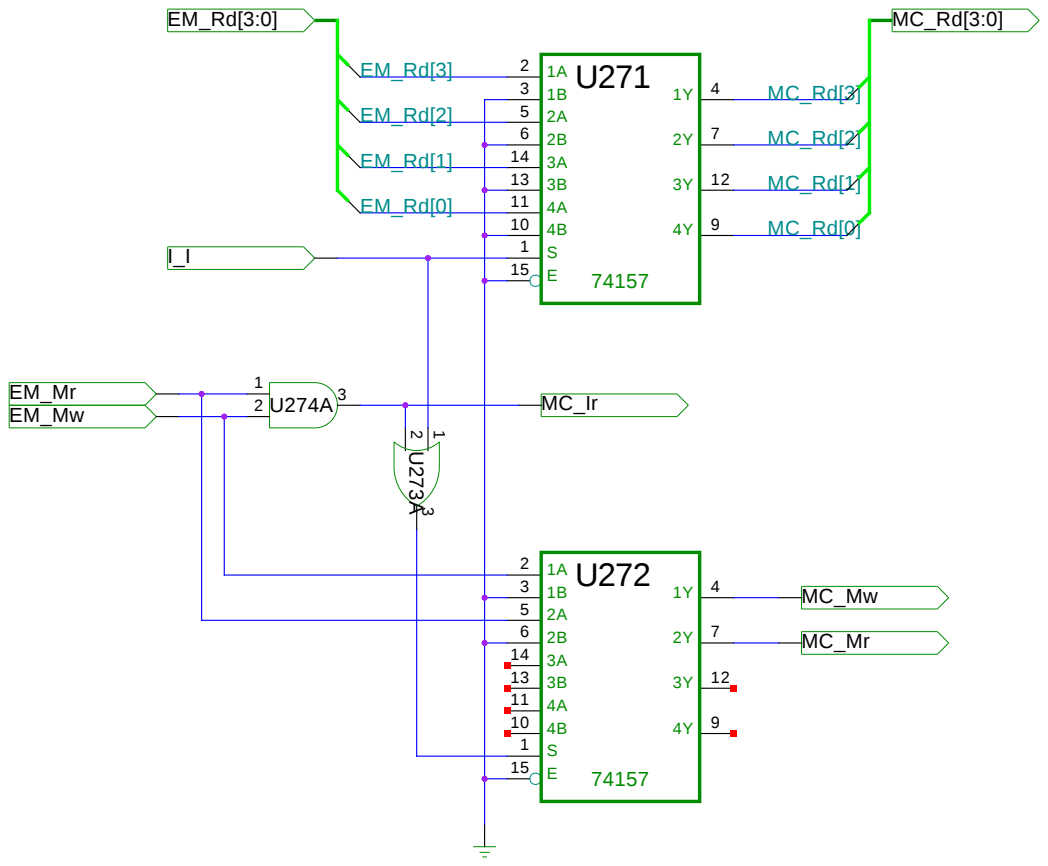
[picture p23: page 22]
FILE:; REVISION:; PAGE; DRAWN BY:; TITLE; MEMORY CONTROL; 2016-06-28-133922 Ian Clark

U287

U288

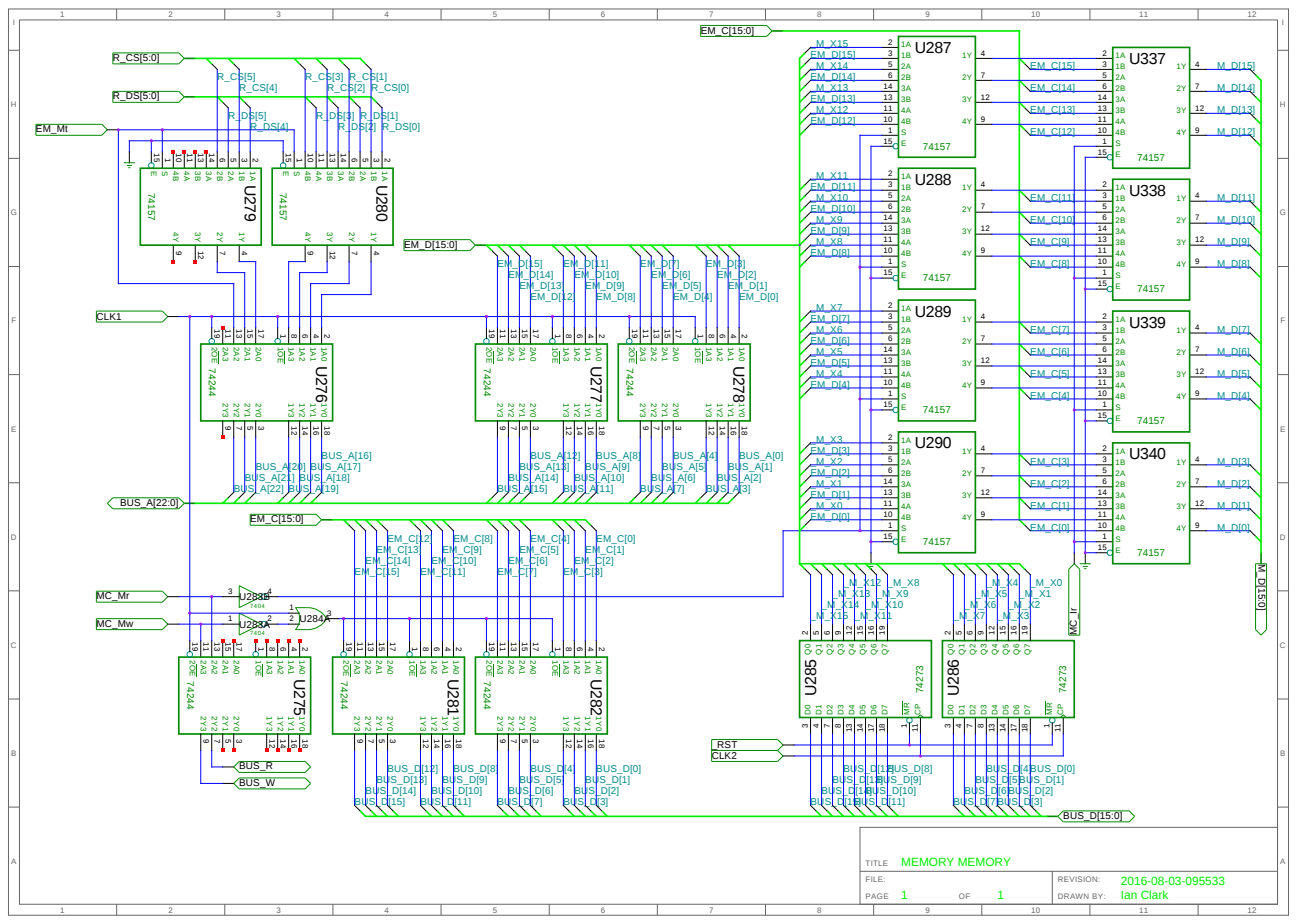
[picture p24: page 23]

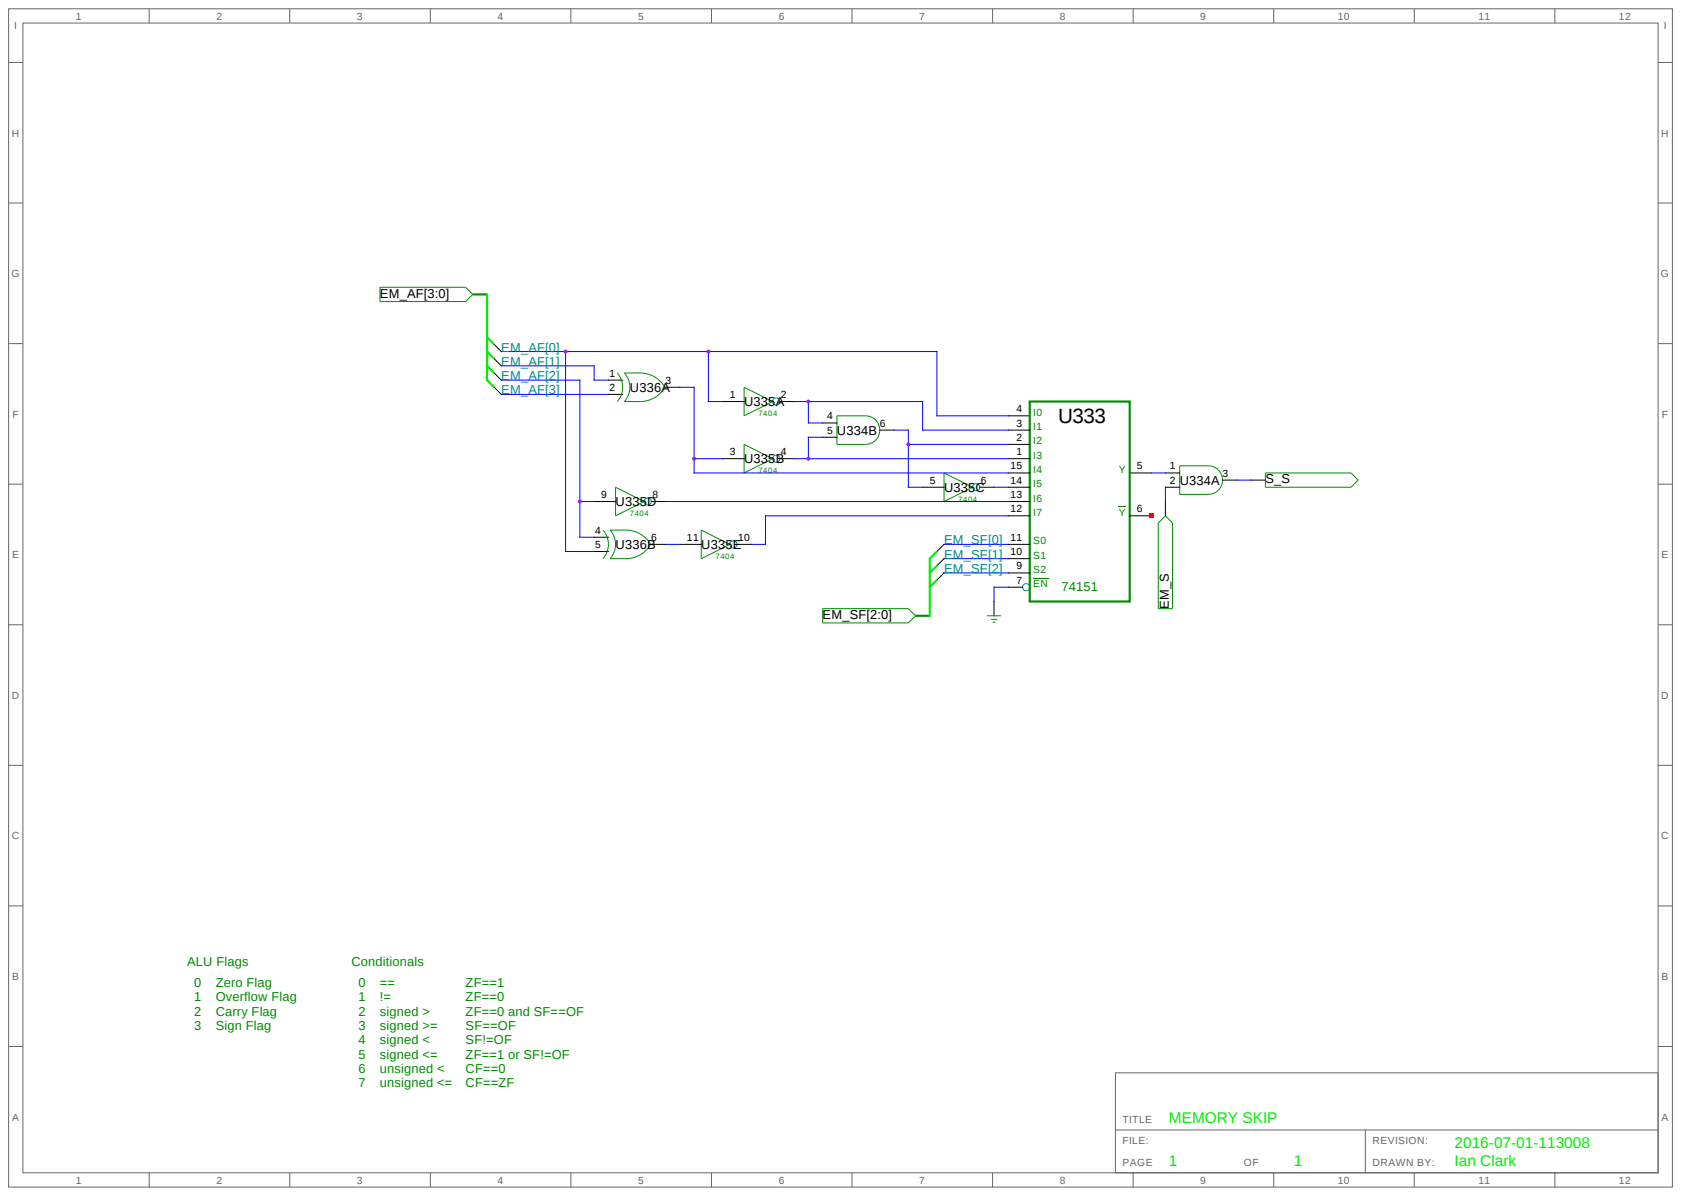
[picture p25: page 24]

ZF==0 and SF==OF

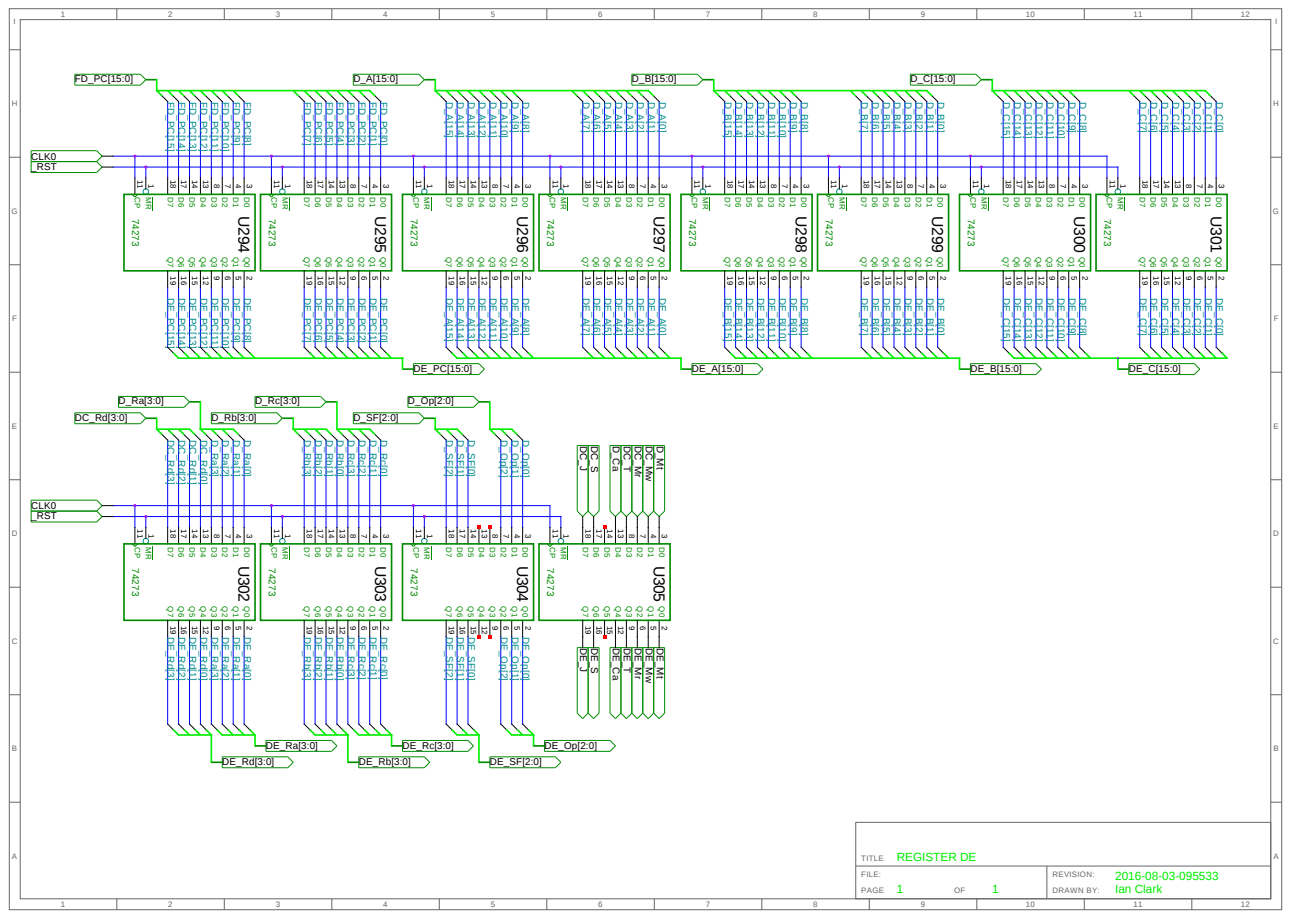
[picture p26: page 25]

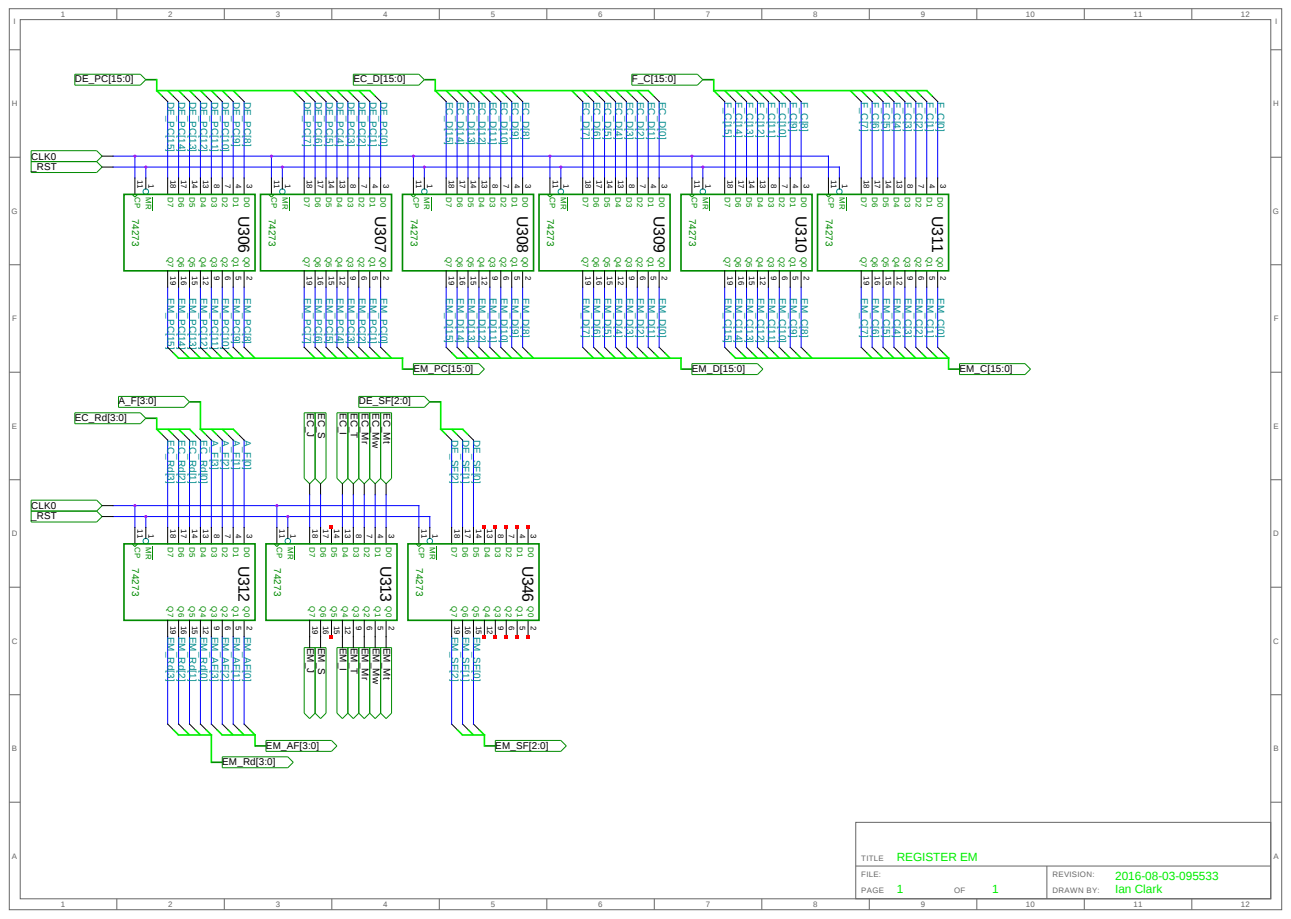
[picture p27: page 26]

U358

U362

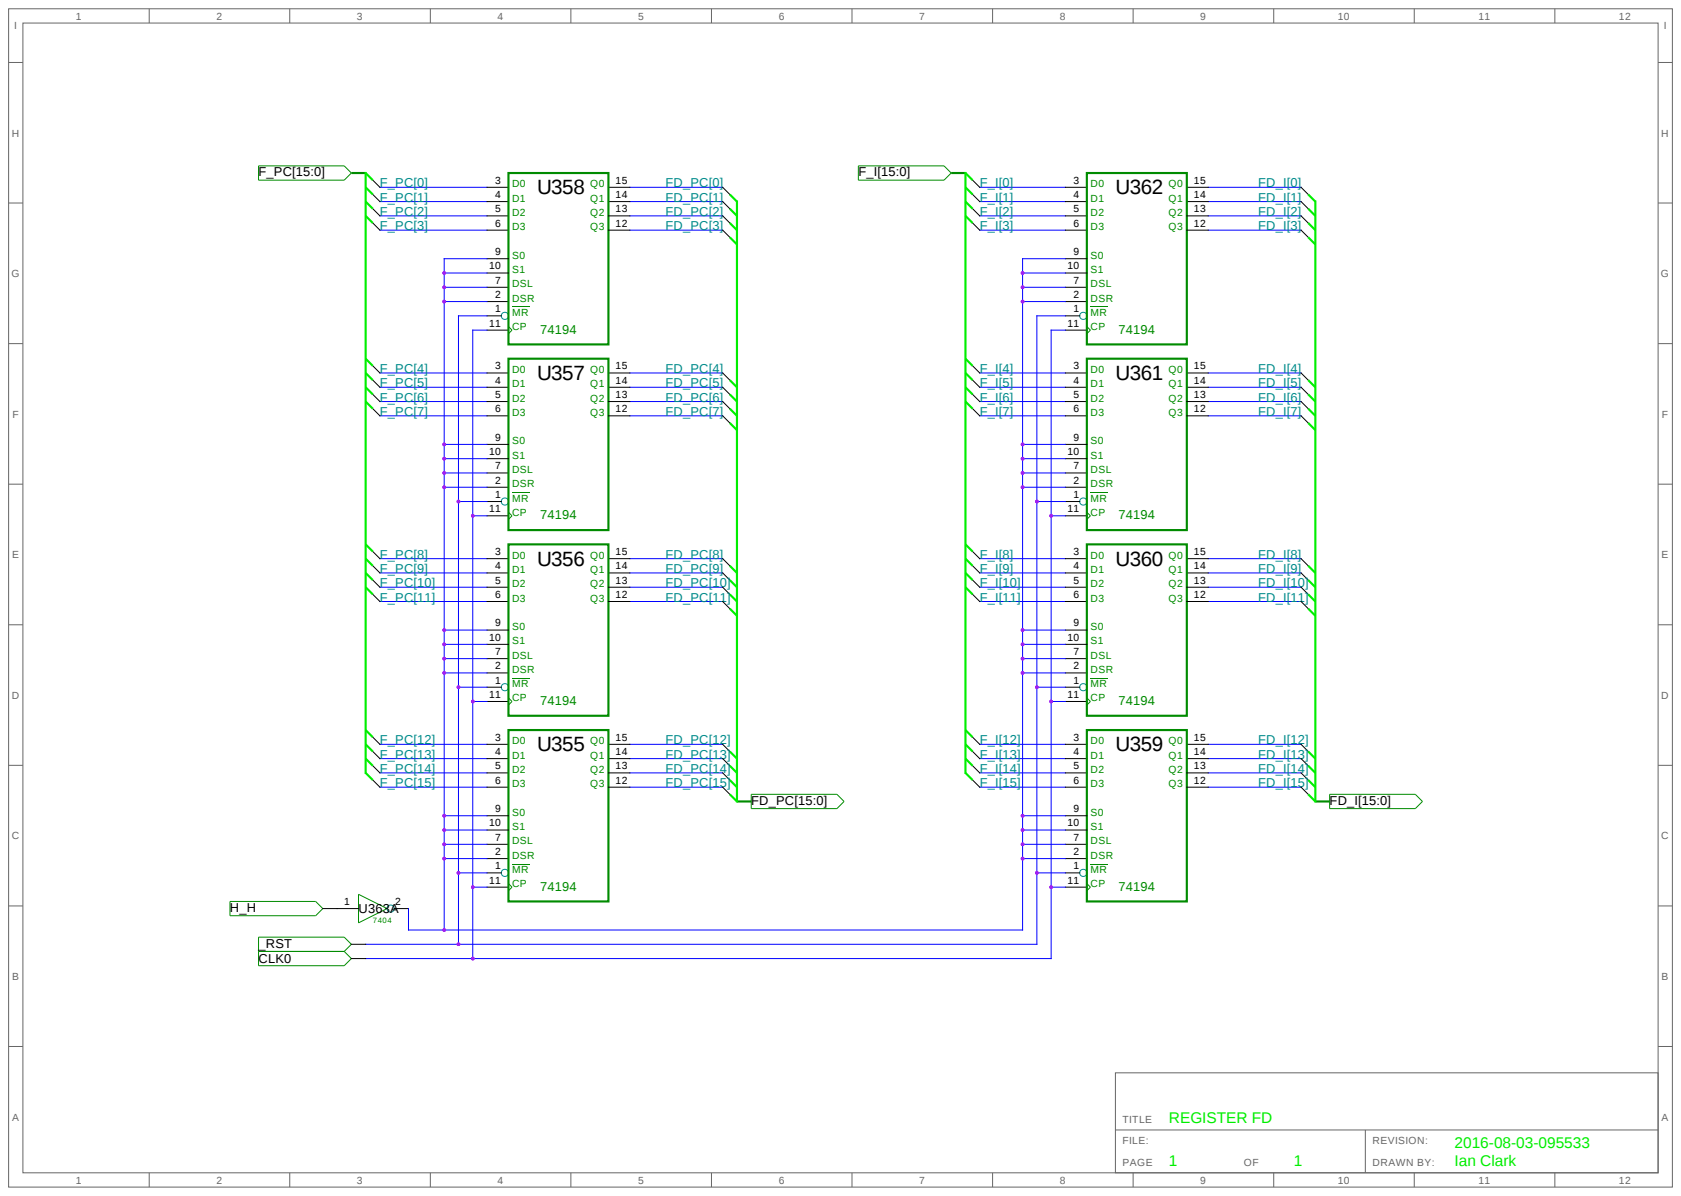
[picture p28: page 27]

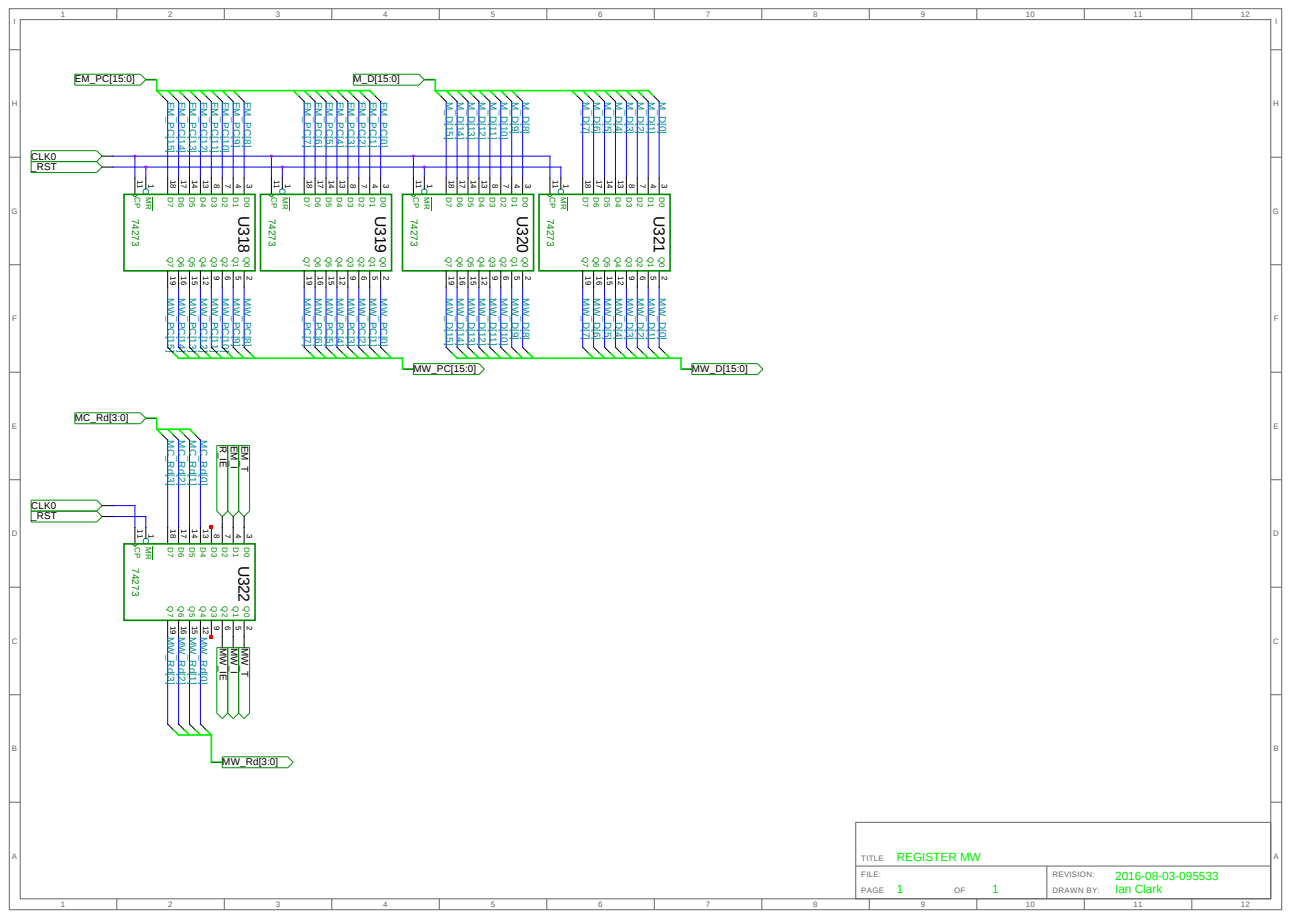
[picture p29: page 28]

U325

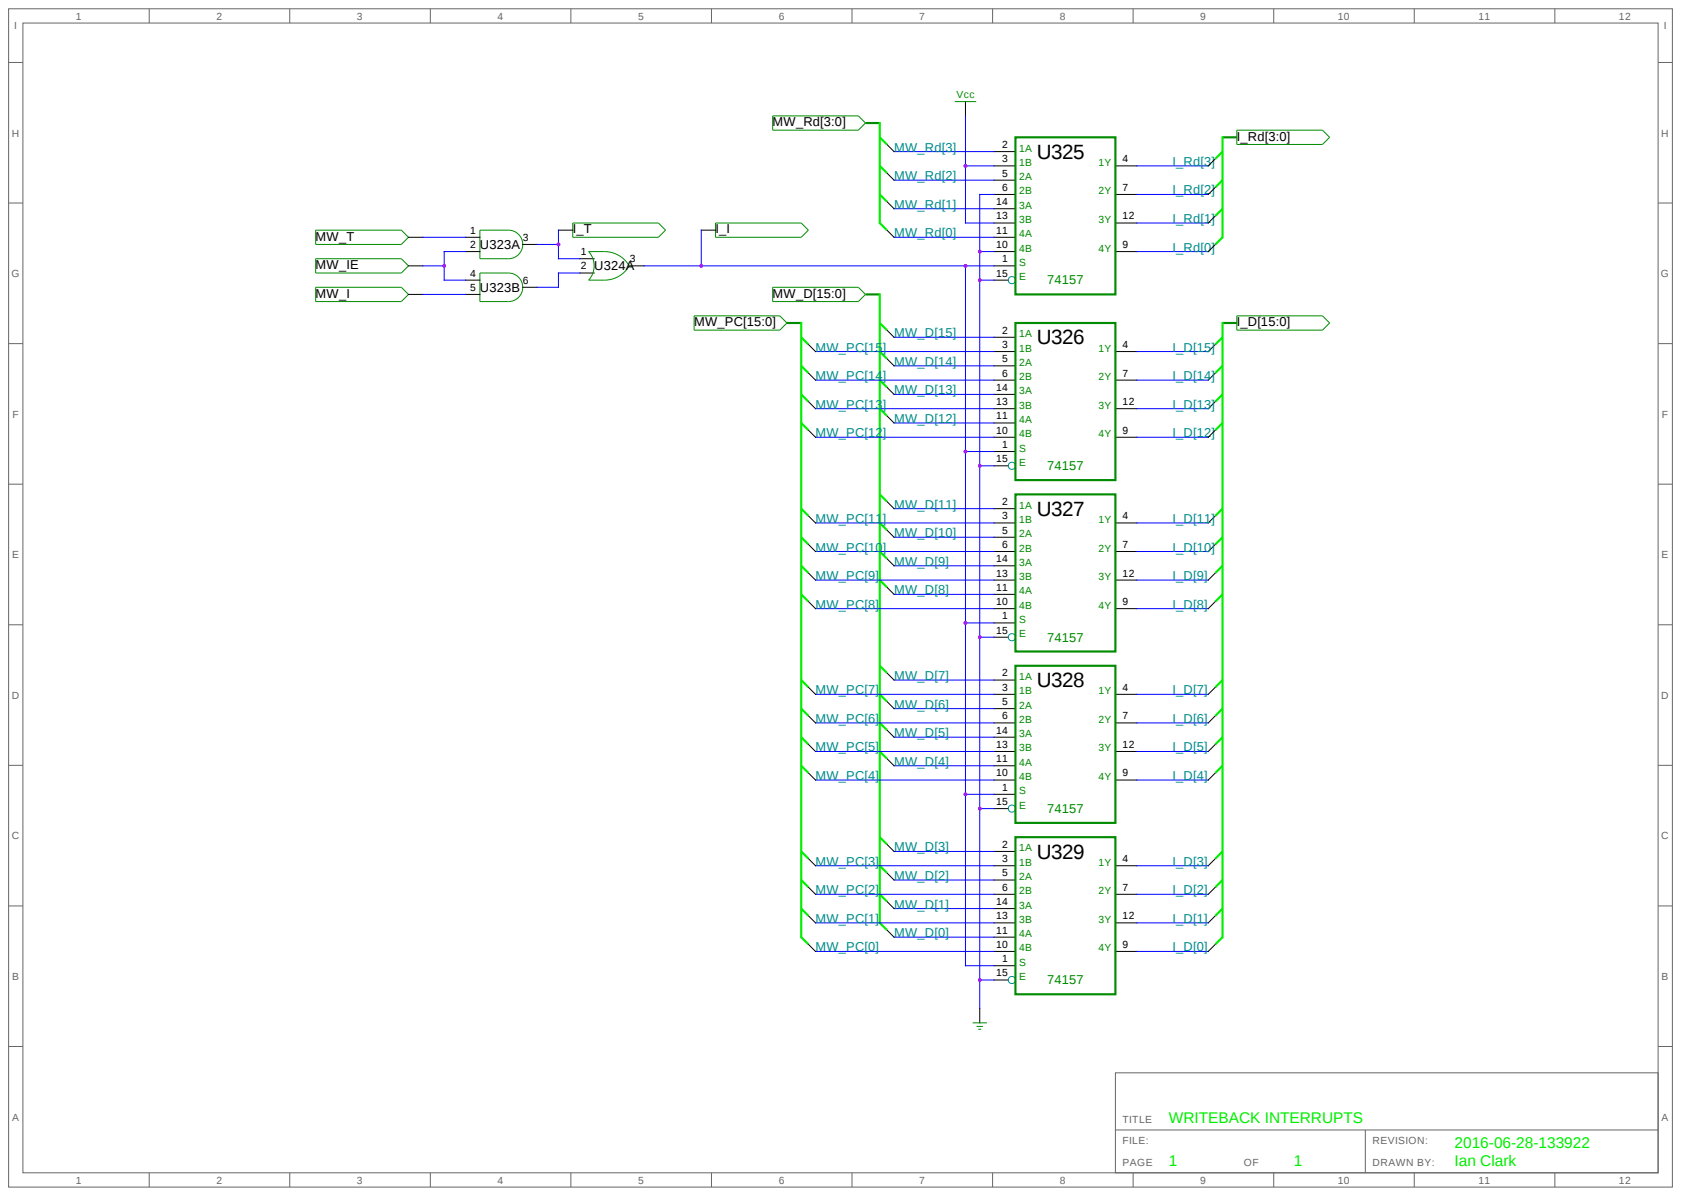
[picture p30: page 29]
FILE:; REVISION:; PAGE; DRAWN BY:; TITLE BCDEFGH; ABCDEFGH; Vcc; WRITEBACK INTERRUPTS; 2016-06-28-133922 Ian Clark
