turbana/cpu/(list of files, drawings)

Other design files:
design/proto.pcb
