turbana/cpu/(commit log)

2013-08-28 Pulled assembler tokens into seperate file.
2013-08-29 Added inital macros and assembler directives.
2013-08-29 Assembler now expands labels with word addressing rather than byte addressing.
2013-08-31 Large changes. Mostly changed how opcodes are parsed and encoded. Changes made to support ISA encoding in one file, so both the assembler and cpu simulation can access the same data.
2013-08-31 Assembler now supports load/stores from labels.
2013-09-02 Added assembler expressions.
2013-09-02 Added test file for assembler expressions.
2014-11-21 Simplified macro processing in assembler
2014-11-21 Improved print messages for <Expr> tokens and the dis-assembler
2014-11-21 Fixed two addi related bugs in fib.asm
    [fib.asm]
2014-11-21 Improved assembler test1
2014-11-23 Finally fixed expression/label parsing bug
    [test1.asm]
2014-11-23 Improved output for assembler test1
2014-11-23 Large ISA changes to assembler and test1
2015-01-18 Updated assembler test1 to reflect ISA changes
2015-01-18 Fixed errors in hand assembling test1.asm
    [test1.asm]
2015-01-19 Updated assembler to new binary format (seperate data/instruction sections)
2015-01-19 Update dis-assembler to new binary format
2015-01-20 Fixed bug in .align macro
    [macros.py]
2015-01-20 Macro expansion now correctly keeps track of sections positions independently
2015-01-23 Added assembler tests for bigint add/sub
2015-01-29 Added basic interrupt test
2015-01-29 Added device and interrupt support to cpu.py
2015-01-30 Changed print statements into func calls to stderr in cpu
2015-02-05 Added test file for assembler sections / .org directive
2015-02-07 Major assembler re-write; new object format; now supports .org directive
2015-02-07 Dis-assembler now supports new object format
2015-02-07 Fixed silly bug in cpu.py; remove debug print statements
2015-02-07 Bare Expressions are now encoded as Numbers; fixes .dw macro having no effect with labels
    [macros.py]
2015-02-07 Interrupts can now be debugged in cpu.py
2015-02-07 Debugger can now trace cpu execution to a file
2015-02-07 Added debug KB device to cpu.py and an almost working real KB device
2015-02-12 Added special label @ (current position); modified screen.asm to use it
2015-02-13 Added assembler variables through the .set directive
2015-02-13 Updated test file macros.asm to use assembler variables
2015-02-14 Changed .call/.ret system to .call/.enter/.leave with actual stack frames
2015-02-14 Changed fib.asm to use new calling convention; now faster and more powerful
2015-02-14 Moved Tracer into listeners.py
2015-02-14 Updated output slightly for Tracer and ErrorChecker
2015-02-14 Added basic test framework output to cpu.py
2015-02-14 Added new testing framework runtest.py
2015-02-14 Modified fib.asm to new testing framework
2015-02-14 runtest.py only generates a trace file upon failure
2015-02-14 Updated tests to new syntax; made notes on missing tests
    [bigintadd.asm, bigintsub.asm, macros.asm, pow.asm, sections.asm, test2.asm, test3.asm, testimem.asm]
2015-02-14 Fixed addi bug in testisa.asm and removed .call/.ret macros with explicit instructions
    [testisa.asm]
2015-02-15 Updated testing framework
2015-02-16 Added --realistic-clock to cpu.py so we can test the machine state during WB stage
2015-02-19 alltests.sh now fails a test when assembling fails; also creates build/ directory
2015-02-19 Added test for assembler immediates
2015-02-24 Better assembler test in alltests.sh
2015-02-24 Assembler macro .enter now works over a larger range of values
2015-02-24 Updated assembler test test1.asm with new ISA
2015-02-24 Renamed assembler macro .dw to .word
2015-02-28 IDT is no longer referenced on interrupt; is now jmp'd to
2015-11-05 Added initial .sch for a barrel shifter
    [barrel_shifter.sch]
2015-11-05 Added initial schematic design (in plain text)
2015-11-05 Updated barrel_shifter.sch: fixed bad enable lines
    [barrel_shifter.sch]
2015-11-10 Added script to ensure schematics can be correctly netlisted (adds required net= lines)
2015-11-10 Updated barrel shifter schematic with verilog input/output pads
    [barrel_shifter.sch]
2015-11-11 Barrel shifter now takes a boolean for shifting right rather than left (had it backwards)
    [barrel_shifter.sch]
2015-11-11 Added schematic for 74157
2015-11-11 Added initial test suite for schematics
2015-11-11 Moved schematic script to central location
2015-11-12 Added schematic build directory to .gitignore
2015-11-12 Added failure message to test bed generation
2015-11-12 Added alias support to test bed generation json
2015-11-12 Added test case assertions to test bed generation
2015-11-12 Added arithmetic shift test case for barrel shifter
2015-11-12 Added arithmetic shift to barrel shifter schematic
    [barrel_shifter.sch]
2015-11-13 Schematic test script will now exits properly (some processes don't exit with non-zero on error :/)
2015-11-13 Updated barrel_shifter.sch with module name
    [barrel_shifter.sch]
2015-11-16 Added saving to schematic api
2015-11-16 update schematic api
2015-11-23 Added new schematic build directory to .gitignore
2015-11-23 Initial execute_control.sch
    [execute_control.sch]
2015-11-28 Added better error message to testmod.py when the schematic doesn't have a proper module definition
2015-11-29 Initial execute_forward.sch
    [execute_forward.sch]
2015-11-30 Initial mux16x4.sch
    [mux16x4.sch]
2015-12-04 Initial 74153.sch
    [74153.sch]
2015-12-16 makesym.py no longer duplicates wires when used more than once in a symbol
2015-12-16 Added 7586 schematic
    [7486.sch]
2015-12-18 7486 is obsolete, changing to 74386
    [74386.sch]
2015-12-18 Revert "7486 is obsolete, changing to 74386"
    This reverts commit 686ef87065faf662dd88f34adbceb00d27eb4e66.
    I was a little hasty. The logic family I'm using (AC) does have a 7486 (74AC86), not a 74386.
    [7486.sch]
2015-12-18 Fixed netlist generation from having multiple Vcc/GND parameters
2015-12-28 Initial 7432
    [7432.sch]
2016-01-05 Pins in symbol creation must have a pinlabel that matches the schematic's refdes. See http://archives.seul.org/geda/user/Nov-2008/msg00148.html
2016-01-08 Register identifiers have only 3 bits not 4, i r dumb
    [execute_control.sch]
2016-01-14 Renamed barrel_shifter to execute_barrel_shifter to bring it under the execute stage
    [execute_barrel_shifter.sch]
2016-01-14 Initial schematic for 74283
    [74283.sch]
2016-01-18 Initial schematic for 7408
    [7408.sch]
2016-01-21 Netlisting now correctly defines Vcc/GND as supplies, not wires
2016-01-22 Initial execute_add.sch
    [execute_and.sch]
2016-01-28 Added new test schematic for new design style
    [test.sch]
2016-01-28 Added searching to schematic.py
2016-01-30 Added better attribute handling to schematic.py
2016-01-30 Added attribute searching to schematic.findall()
2016-01-31 Added attribute updating to schematic.py
2016-01-31 schematic.py can now be used to search schematics from the command line
2016-01-31 Searching with schematic.py now supports = within search terms
2016-02-04 schematic.py now raises an exception when trying to access an attribute that doesn't exist
2016-02-04 Test bench generation now handles both wires and buses
2016-02-05 Updated test case for test.sch
2016-02-05 Updated style of test.sch
    [test.sch]
2016-02-06 Swap i/opad-1 for i/opad-2 (-1 are for wires, -2 are for buses)
2016-02-06 updated test.sch with new i/opads
    [test.sch]
2016-02-08 Updating barrel_shifter with new symbols and style
    [execute_barrel_shifter.sch]
2016-02-19 Ensure that after netlisting all wire widths match their i/opad definitions
2016-02-23 Updated barrel shifter with new 7408 symbol
    [execute_barrel_shifter.sch]
2016-02-24 Shortened wires on custom 74x symbols
2016-02-24 Updated barrel shifter with new custom symbol
    [execute_barrel_shifter.sch]
2016-03-16 Added initial Makefile for schematic workflow
2016-03-17 Added more schematic workflow to Makefile
2016-03-20 Updated 7408 test schematic to new style
    [7408.sch]
2016-03-20 Updated 74153 test schematic to new style
    [74153.sch]
2016-03-20 Updated 74283 test schematic to new style
    [74283.sch]
2016-03-21 Updated 7432 test schematic to new style
    [7432.sch]
2016-03-21 Updated 7486 test schematic to new style
    [7486.sch]
2016-03-22 Removed old schematics (execute_add, execute_and, execute_control, mux16x4, test)
    [execute_add.sch, execute_and.sch, execute_control.sch, mux16x4.sch, test.sch]
2016-03-22 Added multi-schematic builds to Makefile
2016-03-24 execute_barrel_shifter had wrong width for D_ALUop
    [execute_barrel_shifter.sch]
2016-03-24 Cleaned up fix_netlist.py and added multi-schematic support
2016-03-25 Wire names are now used along with aliases from test config
2016-03-26 fix_netlist.py now handles 1-bit wires as well as buses
2016-03-27 Updated footprint for 74157 from DIP16 to SO16
    [execute_barrel_shifter.sch]
2016-03-27 Updated 7408 footprint from DIP14 to SO14
    [execute_barrel_shifter.sch]
2016-03-27 Added prototype board schematic
    [proto.sch]
2016-03-28 Added DIP switches to proto board
    [proto.sch]
2016-03-28 Added pcb generation to Makefile
2016-03-29 Added green LED symbols
2016-03-29 Added Red LED symbol
2016-03-30 Added Green/Yellow LED symbols (Red is out of stock on Mouser)
2016-03-31 Removed wrongly choosen LED symbols
2016-04-01 Added LEDs for A value to proto.sch
    [proto.sch]
2016-04-02 Hooked up A signals to LEDs in proto.sch
    [proto.sch]
2016-04-03 Updated LED footprint from DIP8 to SIP8
    [proto.sch]
2016-04-03 Initial prototype PCB layout
    [proto.pcb]
2016-04-03 Updated proto.pcb
    [proto.pcb]
2016-04-04 Updated DIP switches in proto.sch
    [proto.sch]
2016-04-04 Added symbol for LTL-2550G (2 segment LED)
2016-04-05 Added more indicators to proto.sch
    [proto.sch]
2016-04-05 Added final LEDs to proto.sch
    [proto.sch]
2016-04-05 Added footprint for BX0033 (9v battery clip)
2016-04-05 Added power circuit to proto.sch
    [proto.sch]
2016-04-06 Added values to power circuit in proto.sch
    [proto.sch]
2016-04-06 Added power switch to proto.sch
    [proto.sch]
2016-04-06 Fixed footprint for BX0033
    [proto.sch]
2016-04-06 Updated footprints for switch and voltage regulator in proto.sch
    [proto.sch]
2016-04-07 Updated proto.pcb with new components/footprints
    [proto.pcb]
2016-04-07 Added DRC values to proto.pcb for Seeed fabrication
    [proto.pcb]
2016-04-07 Layed out voltage regulation in proto.pcb
    [proto.pcb]
2016-04-07 Fixed typo in output pins in proto.sch
    [proto.sch]
2016-04-08 Layed out data LEDs in proto.pcb
    [proto.pcb]
2016-04-08 Fixed LED pins in proto.sch
    [proto.sch]
2016-04-08 Updated LED layout in proto.pcb
    [proto.pcb]
2016-04-09 Updated pcb layout
    [proto.pcb]
2016-04-10 Added pcb backups (*-) to .gitignore
2016-04-11 Changed LEDs from through-hole strips to individual SMD
    [proto.sch]
2016-04-11 Changed resistor footprints from 1206 to 0603 in proto.sch
    [proto.sch]
2016-04-11 Imported changes in schematic to proto.pcb
    [proto.pcb]
2016-04-11 Fixed 2 unconnected LEDs in proto.sch
    [proto.sch]
2016-04-11 Sorted LED layout in proto.pcb
    [proto.pcb]
2016-04-13 Added initial prototype alu (changing from barrel shifter)
    [proto_alu.sch]
2016-04-14 Switching proto.sch from barrel shifter to simple alu
    [proto.sch]
2016-04-17 Changed 74283, 7432, 7486 to SMD parts from TO
    [proto.sch, proto_alu.sch]
2016-04-18 Updated proto.pcb with new alu varient
    [proto.pcb]
2016-04-18 Fixed LED/R numbering in proto.sch
    [proto.sch]
2016-04-18 Fixed more LED/R naming in proto.sch
    [proto.sch]
2016-04-18 Initial pcb layout for proto alu
    [proto.pcb]
2016-04-18 Changed switch pins for Op in proto.sch
    [proto.sch]
2016-04-22 Updated proto layout
    [proto.pcb]
2016-04-24 Added carry in/out to proto_alu.sch
    [proto_alu.sch]
2016-04-25 Added LEDs for carry in/out to proto.sch
    [proto.sch]
2016-04-25 Added LEDS for carry in/out to proto layout
    [proto.pcb]
2016-04-25 Proto layout updates
    [proto_alu.sch]
2016-04-25 Added initial main design schematic (copying from hardcopy)
    [design.sch]
2016-04-26 Updated main design
    [design.sch]
2016-05-05 Added schematic parsing support for lines
2016-05-05 Updated gafrc with footprint library (needed for pcb)
2016-05-12 Renamed block diagram schematic
    [block_diagram.sch]
2016-05-16 Updated test1.asm with correct values and new ISA
    [test1.asm]
2016-05-17 Disable all assembler tests until they can be updated
2016-05-19 Fixed .call/.return assembler macros
    [macros.py]
2016-05-19 Updated assembler tests
2016-05-20 Updated assembler test testisa.asm
2016-05-20 cpu.py now stalls when reading after either ldw or ldiw (was only ldw)
2016-05-21 Cleaned up block diagram a bit
    [block_diagram.sch]
2016-05-21 More block diagram cleanup and added control lines for reti instruction
    [block_diagram.sch]
2016-05-21 Updated block diagram to optimize interrupt writing to
    [block_diagram.sch]
2016-05-23 cpu.py --trace now shows correct clock
2016-05-24 Updated line thinkness in block diagram
    [block_diagram.sch]
2016-05-24 Updated block diagram with instruction fetch hardwired CS to 0
    [block_diagram.sch]
2016-05-25 Updated devices and interrupts in cpu.py
2016-05-25 Updated timer.asm with new interrupts
2016-05-26 Fixed bug in cpu.py with reti not enabling interrupts
2016-05-30 Added initial task switch code
2016-05-31 Updated tasks.asm with full processes switching
2016-05-31 In tasks.asm: don't enable interrupts before we're ready
2016-06-01 Splitting execute_forward.sch into 3 parts (A,B,C)
    [execute_forward_a.sch]
2016-06-02 Added definitions for currently used 74 series gates
2016-06-02 Removed unneeded files for 74 series gates
    [7408.sch, 74153.sch, 74283.sch, 7432.sch, 7486.sch]
2016-06-04 Added test case for execute_forward_a
2016-06-04 Updated schematic for Forward A
    [execute_forward_a.sch]
2016-06-04 Added schematics for Forwarding B/C
    [execute_forward_b.sch, execute_forward_c.sch]
2016-06-04 Renumbered refdes in execute_forward_*.sch
    [execute_forward.sch, execute_forward_a.sch, execute_forward_b.sch, execute_forward_c.sch]
2016-06-04 Updated tests and schematics for execute_alu
    [execute_alu.sch, execute_alu_bs.sch]
2016-06-05 Intermediate schematics no longer require a corresponding .sch
2016-06-05 Seperated execute_alu.sch into multiple schematics
    [execute_alu.sch, execute_alu_1.sch, execute_alu_2.sch]
2016-06-05 Updated title border of execute_alu_bs
    [execute_alu_bs.sch]
2016-06-05 Changed internal ALU wire name (barrel shifter)
    [execute_alu_1.sch, execute_alu_bs.sch]
2016-06-05 Updated title block for execute_alu_1
    [execute_alu_1.sch]
2016-06-06 Moved prototype schematics into seperate directory tree
    [proto.sch, proto_alu.sch]
2016-06-06 Updated 'make testall' to only test schematics with a test config
2016-06-06 Added 'make doc' to generate pdf of all schematics
2016-06-06 Added block diagram and schematics to README
2016-06-11 Fixed incorrectly named output wire in execute_alu_bs
    [execute_alu_1.sch, execute_alu_bs.sch]
2016-06-11 Simplified test case generation syntax
2016-06-11 Added A_Z wire to execute_alu
    [execute_alu_1.sch]
2016-06-11 Updated block diagram for exeecute control
    [block_diagram.sch]
2016-06-13 Added execute_control.sch
    [execute_control.sch]
2016-06-13 Updated schematics.pdf
2016-06-13 Added memory_skip.sch
    [memory_skip.sch]
2016-06-13 Added memory_control.sch
    [memory_control.sch]
2016-06-13 Added writeback_interrupts.sch
    [writeback_interrupts.sch]
2016-06-14 Added decode_hazard.sch
    [decode_hazard.sch]
2016-06-14 Updated decode_hazard to no longer hazard on writing to bash
    [decode_hazard.sch]
2016-06-15 Updated block diagram (removed feedback loop from decode hazard)
    [block_diagram.sch]
2016-06-15 Fixed memory_skip (wasn't skipping when Snz=0 and Z=0)
    [memory_skip.sch]
2016-06-15 Added decode_control.sch
    [decode_control.sch]
2016-06-17 Added initial clock generation
    [clock.sch]
2016-06-17 gengate.py now correctly expands basic wires in clocked expressions
2016-06-17 gengate.py now correctly lines up ? wires when multiple sets are defined in different orders
2016-06-17 Initial fetch_pc.sch
    [fetch_pc.sch]
2016-06-17 Updated fetch_pc.sch
    [fetch_pc.sch]
2016-06-17 Added title block generation to schematics.pdf
2016-06-17 Renamed execute_forward_{a,b,c}.sch to {1,2,3} for new schematic.pdf page numbers
    [execute_forward_1.sch, execute_forward_2.sch, execute_forward_3.sch]
2016-06-17 Optimized execute_alu_1.sch slightly
    [execute_alu_1.sch]
2016-06-21 Added test case and extra CLKs to clock.sch
    [clock.sch]
2016-06-21 Updated fetch_pc.sch to use CLK1 as clock
    [clock.sch, fetch_pc.sch]
2016-06-21 Minimized clock delays in clock.sch
    [clock.sch]
2016-06-22 Added 74126 (Quad bus driver; 3-state; high enable)
2016-06-22 Added initial fetch_fetch.sch
    [fetch_fetch.sch]
2016-06-22 Updated CLK2/3 so that we have a rising edge at every 1/4 clock
    [clock.sch]
2016-06-22 Fixed bug in tri-state test case generation (wasn't going to high-z)
2016-06-22 Added bus register to fetch_fetch.sch
    [fetch_fetch.sch]
2016-06-22 Renamed wires BUS_Mw/Mr to BUS_W/R
    [block_diagram.sch, fetch_fetch.sch]
2016-06-23 Added 74244 (Octal buffer/line driver; 3-state)
2016-06-23 Fixed incorrect wire in 74244 symbol
2016-06-23 Test bench bus wires now follow arbitrary expressions (to support only driving on a clock and wire combination)
2016-06-23 Added memory module
    [memory_memory.sch]
2016-06-23 Updated block diagram (added PC to register file inputs)
    [block_diagram.sch]
2016-06-25 Added initial decode_rf_cregs.sch
    [decode_rf_cregs.sch]
2016-06-25 Added initial decode_rf_regs.sch
    [decode_rf_regs.sch]
2016-06-25 Added initial decode_rf_a_*.sch
    [decode_rf_a_1.sch, decode_rf_a_2.sch, decode_rf_a_3.sch]
2016-06-25 Fixed typos in register file
    [decode_rf_a_2.sch, decode_rf_cregs.sch, decode_rf_regs.sch]
2016-06-25 Removed extra GP register and fix typos in decode_rf
    [decode_rf_cregs.sch, decode_rf_regs.sch]
2016-06-25 Added gtkwave save file for decode_rf and filter file for registers
2016-06-25 Fixed wrong GP register select in decode_rf_a
    [decode_rf_a_1.sch]
2016-06-26 Fixed decode_rf_a from reading wrong control register
    [decode_rf_a_2.sch]
2016-06-26 Register file now checks mode before saving value
    [decode_rf_cregs.sch]
2016-06-27 Misc bugfixes
    - Test bench only generates _CLK wire when not already defined by module
    - Test configs are now merged properly (was merging "initial" into "inputs")
    - Fixed old test config "static" section into newer "initial"
    - Fixed old test configs referencing U0.CLK* (no longer need device reference)
2016-06-27 fix_netlist.py now changes duplicate wires into inout
2016-06-27 module_name= is now added to schematics
2016-06-27 Added R_CS/DS to decode_rf
    [decode_rf_a_2.sch, decode_rf_cregs.sch]
2016-06-27 Updated decode_rf_cregs to save -> when interrupting
    [decode_rf_a_2.sch, decode_rf_cregs.sch]
2016-06-27 decode_rf_cregs now resets on interrupt
    [decode_rf_cregs.sch]
2016-06-27 Merged 2nd/3rd sheets of decode_rf_a together
    [decode_rf_a_2.sch, decode_rf_a_3.sch]
2016-06-27 Added B/C ports to register file
    [decode_rf_b_1.sch, decode_rf_b_2.sch, decode_rf_c_1.sch, decode_rf_c_2.sch]
2016-06-27 R_IE now goes through WM stage register before interrupts section to avoid feedback loop
    [block_diagram.sch, writeback_interrupts.sch]
2016-06-27 I_I is now set when either interrupting or trapping; I_T is only set on trapping
    [execute_control.sch, writeback_interrupts.sch]
2016-06-27 R_M is now sent to fetch where it selects correct segment
    [block_diagram.sch, fetch_fetch.sch]
2016-06-27 Added FD stage register
    [register_fd.sch]
2016-06-27 Added DE stage register
    [register_de.sch]
2016-06-28 Added EM stage register
    [register_em.sch]
2016-06-28 Added MW stage register
    [register_mw.sch]
2016-06-28 Added circle and arc to schematic parsing
2016-06-28 schematic.py now allows setting an attribute that doesn't exist yet
2016-06-28 Renumbered all component's refdes
    [clock.sch, decode_control.sch, decode_hazard.sch, decode_rf_a_1.sch, decode_rf_a_2.sch, decode_rf_b_1.sch, decode_rf_b_2.sch, decode_rf_c_1.sch]
2016-06-30 Added Skip Flags and ALU Flags to block diagram
    [block_diagram.sch]
2016-06-30 Updated ALU with flags (Sign, Carry, Overflow, Zero)
    [execute_alu_1.sch, execute_alu_2.sch]
2016-07-01 Updated ALU overflow flag to addition overflow rather than subtraction overflow
    [execute_alu_1.sch]
2016-07-01 Updated memory_skip with alu/skip flags
    [memory_skip.sch]
2016-07-01 Updated block digram: moved MC_Ir wire straight to Memory only; EM_J now also goes to DC and FC
    [block_diagram.sch]
2016-07-01 Update memory_memory to pass along EM_C when MC_Ir is set
    [memory_memory.sch]
2016-07-01 Updated decode_hazard to only assert H_H when not jumping
    [decode_hazard.sch]
2016-07-01 Updated decode_control to nop when jumping
    [decode_control.sch]
2016-07-01 Added fetch_control
    [fetch_control.sch]
2016-07-01 Removed port C from register file
    [block_diagram.sch, decode_hazard.sch, decode_rf_c_1.sch, decode_rf_c_2.sch]
2016-07-01 Updated register_em with skip/alu flags
    [register_em.sch]
2016-07-01 Added skip flags to register_de
    [register_de.sch]
2016-07-01 Added carry in to alu
    [execute_alu_2.sch]
2016-07-03 Added encoding searcher using espresso as logic minimizer
    [decode.csv]
2016-07-06 Updated ISA and assembler tests
2016-07-07 Cleaned up special case code for I/R handling
2016-07-19 Updated to gEDA 1.9.2
    1) *pad-1.sym needed pinnumber= set to 1 (rather than *PAD)
    2) Fixed a couple of wire aliases in execute_alu
    [execute_alu_1.sch, execute_alu_2.sch]
2016-07-20 Updated decode searcher
    [decode.csv]
2016-07-20 gtkwave filters for conditions/aluops
2016-07-20 Major build clean up
    Renamed most scripts
    Moved scripts under bin/
    Moved config files under config/
    [decode.csv]
2016-07-21 Renamed DE_ALUOp to DE_Op
    [execute_alu_1.sch, execute_alu_2.sch, execute_alu_bs.sch]
2016-07-21 Added devices.v and tim.v (integration modules)
2016-07-27 Fixed typo in EM stage register
    [register_em.sch]
2016-07-27 Moved Makefile (and design/{bin,etc}/ directories) to project root
    [decode.csv]
2016-07-29 Added assembler build+tests to Makefile
2016-07-30 Added test cases for stage registers
2016-07-30 Fixed typo in tim.v
    [tim.v]
2016-08-07 Missed renaming D_Ra/b to D_RFa/b
    [decode_hazard.sch, decode_rf_a_1.sch, decode_rf_a_2.sch, decode_rf_b_1.sch, decode_rf_b_2.sch]
2016-08-07 cpu.py offsets instruction memory by 1
    Temporary change until reset circuitry is added
2016-08-07 Fixed error in decoding logic
    D_Rb wasn't being set to 0 when D_B was an immediate value
    [decode.csv]
2016-08-07 Memory in devices.v now delays writes 50ns
2016-08-07 Fixed error in decoding logic for jmp
    [decode.csv]
2016-08-07 Inverting bits for subtraction is moved into ALU
    Before we were flipping the bits of R_B when performing a subtraction.
    This worked for values coming from the ALU, but failed when a value was
    forwarded. Now we flip the bits of B inside the ALU when performing an
    'add' and when carry in is set.
    [decode.csv, execute_alu_2.sch, execute_alu_3.sch]
2016-08-07 Added _RST signal to all register chips
    [clock.sch, decode_rf_control.sch, decode_rf_cregs.sch, decode_rf_regs.sch, fetch_fetch.sch, fetch_pc.sch, memory_memory.sch, register_de.sch]
2016-08-07 Added TC1232 watchdog chip for reset signal generation
    [clock.sch]
2016-08-07 PC is now reset to 40E000 (EEPROM)
    [fetch_pc.sch]
2016-08-07 Integ test now uses faux "bootloader" to load programs
    Fixes the off-by-one instruction delay
    [tb_tim.v]
2016-08-07 ALU now performs sex
    [execute_alu_1.sch]
2017-04-13 Assembler strings now support \n, \t, \r
2017-04-13 Updated echo.asm with "new" interrupt handling
2017-04-16 Exceptions raised during assembler parsing are no longer suppressed
